AetheRZX/MECH_458/Enclsoure_CAD/trendnet-ti-pg160-1.snapshot.4/TRENDnet TI-PG160 Front Decal.png

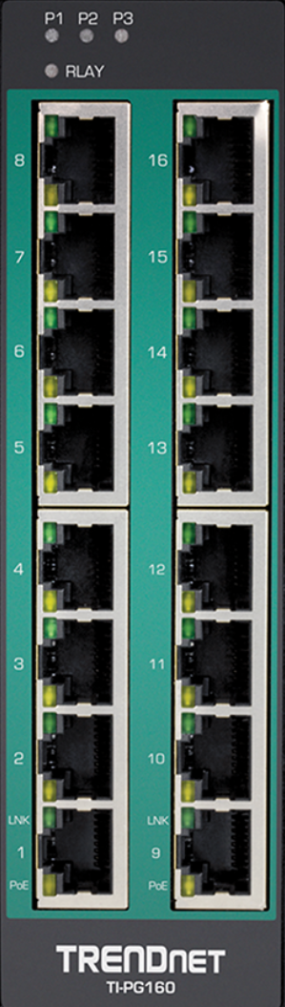
Enclsoure_CAD/trendnet-ti-pg160-1.snapshot.4/TRENDnet TI-PG160 Front Decal.png
