AetheRZX/MECH_458/Poster/Airbus_Flip_Table_Poster_36x48.html

AIRBUS

Robotics — Flip Table Redesign

AIRBUSFLIP TABLE

Automated Vertical & Rotational Positioning System

TEAM T2

THE UNIVERSITY OF BRITISH COLUMBIA

Faculty of Applied Science · Mechanical Engineering

Kenneth · Gyan · Ryan · Oliver · Mfon · Jordan

Project Overview

Client: Airbus Robotics

Flip tables are large tabletops (~2.4 m × 1.8 m) that vertically translate and rotate. They simulate fuselage positions for robots used to drill or install fasteners on an aircraft fuselage at different orientations.

Problem

Current flip tables are manually rotated and difficult to operate, limiting throughput and introducing ergonomic risk for operators.

Objectives & Scope

- Redesign the flip table to implement automated vertical and rotational motion
- Integrate a safety system and Human-Machine Interface (HMI)
- Improve ergonomic design and ease of access over and under the table
- Achieve a minimum vertical speed of 0.05 m/s

*Rotation was downscoped after client discussion — a separate detailed rotation design will be provided.

Design Process

1

Client Needs & Requirements

→

2

Concept Generation

→

3

Detailed Design & FEA

→

4

Prototype Build & Test

Prototype Specifications

Parameter | Value
Table Dimensions | ~2.4 m × 1.8 m
Under-Table Clearance | ≥ 6 ft (min.)
Static Load Capacity | 1,000 lb
Dynamic Load Capacity | 500 lb
Vertical Speed | ≥ 0.05 m/s
Safety System | E-Stop, Light Curtain
HMI | Touchscreen + Physical Controls

Evaluation Criteria

Ergonomics

30%

Time to Design

20%

Time to Build

15%

Cost

15%

Min. Height

10%

Angular Stability

10%

Final CAD Assembly

↑ Insert final CAD render / photograph here

Key Performance Metrics

6 ft+

Under-table Clearance

1000 lb

Static Load Capacity

500 lb

Dynamic Load Capacity

0.05 m/s

Min. Vertical Speed

HMI Control Interface

AIRBUS FLIP TABLE

SYSTEM READY

HEIGHT

3.50

ft

TARGET

7.00

ft

ANGLE

30.0

deg

▲ UP

⌂ HOME

■ E-STOP

FEA Stress Analysis

↑ Insert FEA stress analysis screenshot here

Testing & Validation

Verification Criteria

Test | Target | Result
Vertical Translation | ≥ 0.05 m/s | ✓ PASS
Static Load | 1,000 lb | ✓ PASS
Dynamic Load | 500 lb | ✓ PASS
Under-Table Clearance | ≥ 6 ft | ✓ PASS
E-Stop Response | < 1 s | ✓ PASS
Angular Stability | ≤ 0.5° | ~ CHECK

Prototype Photo

↑ Insert prototype photograph here

Subsystem Breakdown

Vertical

Complete

Rotational

Design Only

Electrical

Complete

Controls / HMI

Complete

Safety

Integrated

Recommendations

Overall

Add safety cage / light curtain Reduce assembly weight Redesign for DFMA

Vertical Subsystem

Use stainless steel channels Add polycarbonate cover Add rigging provisions

Rotational Subsystem

Lower torque brake & gearbox combo Improve redundant braking

Electrical & Controls

Safety switch on cabinet Refine control algorithm

AIRBUS ROBOTICS · Capstone Project 2025–2026

UBC Mechanical Engineering · Design & Innovation Day

TEAM T2 · 36″ × 48″ Poster
