AetheRZX/MECH_458/Poster/Airbus_Flip_Table_Poster_36x48.pptx

AIRBUS FLIP TABLE

Automated Vertical & Rotational Positioning System

PROJECT OVERVIEW

CLIENT: AIRBUS ROBOTICS

Flip tables are large tabletops (~2.4m × 1.8m) that vertically translate and rotate. They simulate fuselage positions for robots used to drill or install fasteners on an aircraft fuselage at different orientations.

PROBLEM

Current flip tables are manually rotated and difficult to operate, limiting throughput and introducing ergonomic risk for operators.

OBJECTIVE

Redesign the flip table to implement automated vertical translation with integrated safety, HMI, and improved ergonomics.

AIRBUS

ROBOTICS · CAPSTONE 2025–2026

FINAL CAD ASSEMBLY

INSERT CAD RENDER / 3D MODEL HERE

THE UNIVERSITY OF BRITISH COLUMBIA

Mechanical Engineering · Team T2

Kenneth · Gyan · Ryan · Oliver · Mfon · Jordan

KEY PERFORMANCE METRICS

6 ft+

Under-Table
Clearance

1000 lb

Static Load
Capacity

500 lb

Dynamic Load
Capacity

0.05 m/s

Min. Vertical
Speed

TEAM T2

SCOPE & REQUIREMENTS

- Automate vertical and rotational motion
- Integrate safety system & Human-Machine Interface (HMI)
- Improve ergonomic design and operator access
- Minimum vertical speed: 0.05 m/s
- Min. 6 ft clearance under tabletop
- Static load: 1,000 lb | Dynamic load: 500 lb

*Rotation downscoped after client discussion — separate detailed design provided.

TESTING & VALIDATION

TEST | TARGET | RESULT
Vertical Translation | ≥ 0.05 m/s | ✓ PASS
Static Load | 1,000 lb | ✓ PASS
Dynamic Load | 500 lb | ✓ PASS
Under-Table Clearance | ≥ 6 ft | ✓ PASS
E-Stop Response | < 1 s | ✓ PASS
HMI Response | < 0.5 s | ✓ PASS
Angular Stability | ≤ 0.5° | ~ CHECK

FEA STRESS ANALYSIS

INSERT FEA RESULTS IMAGE HERE

Low

WIRING DIAGRAM

Replace with actual wiring schematic

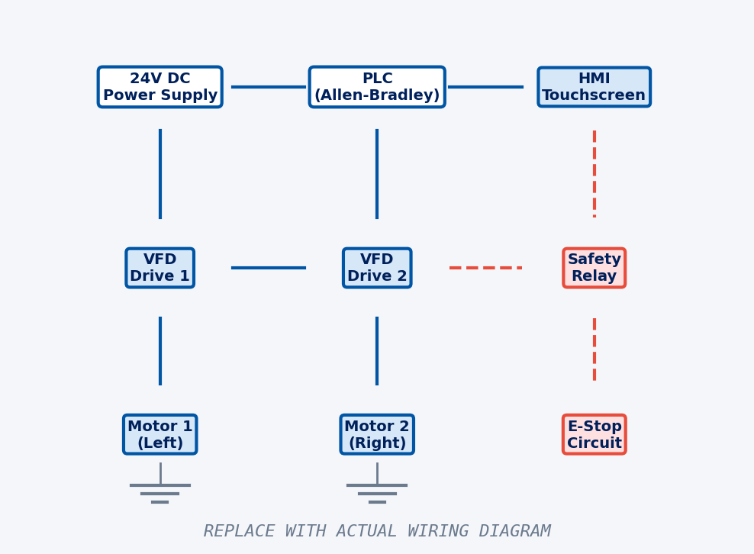
[picture p2: figure]

PROTOTYPE SPECIFICATIONS

PARAMETER | VALUE
Table Dimensions | ~2.4 m × 1.8 m
Under-Table Clearance | ≥ 6 ft (min.)
Static Load Capacity | 1,000 lb
Dynamic Load Capacity | 500 lb
Vertical Speed | ≥ 0.05 m/s
Safety System | E-Stop, Light Curtain
HMI | Touchscreen + Physical Controls
Rotation | Design provided separately

LOAD vs. DISPLACEMENT

Placeholder data — replace with actual test results

High

PROTOTYPE

INSERT PROTOTYPE PHOTO HERE

EVALUATION CRITERIA

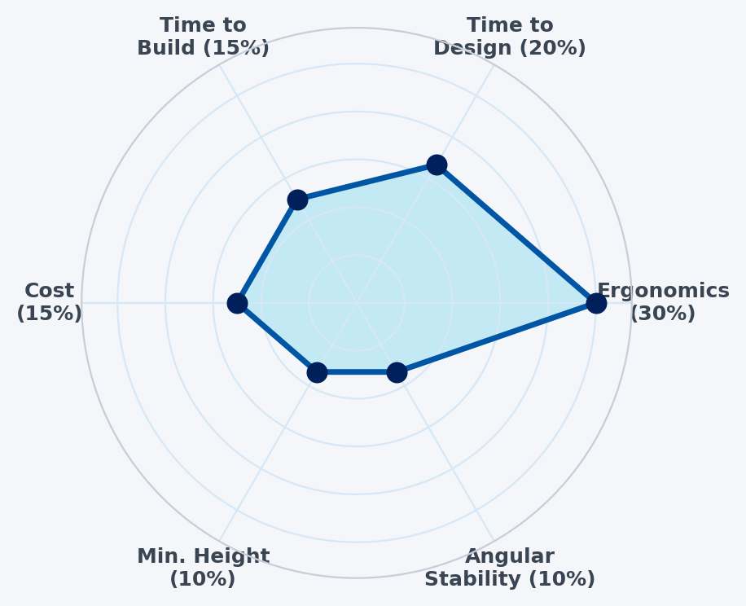
[picture p3: figure]

CONTROL SYSTEM ARCHITECTURE

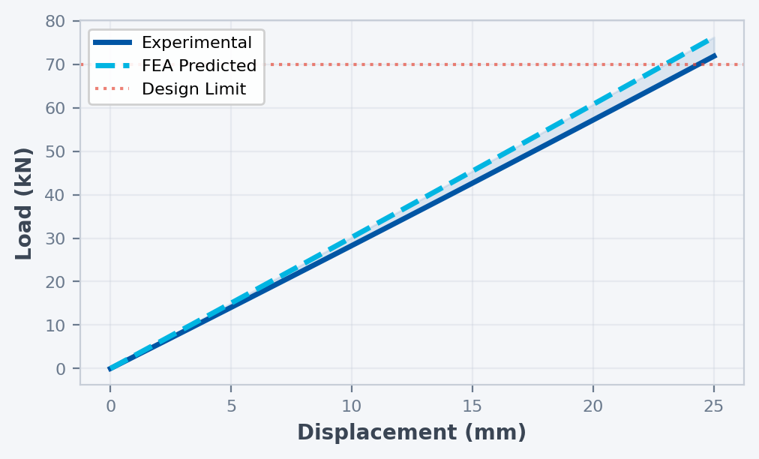
[picture p4: figure]

RECOMMENDATIONS

Overall

- Add safety cage or light curtain
- Reduce assembly weight
- Redesign for DFMA

Vertical Subsystem

- Optimize with stainless steel channels
- Add polycarbonate cover
- Add rigging provisions

Rotational Subsystem

- Lower torque brake & gearbox
- Improve redundant braking mechanism

Electrical & Controls

- Add safety switch on cabinet
- Refine PID control algorithm

DESIGN PROCESS

Client Needs &
Requirements

1

→

Concept
Generation

2

→

Detailed
Design & FEA

3

→

Prototype
Build & Test

4

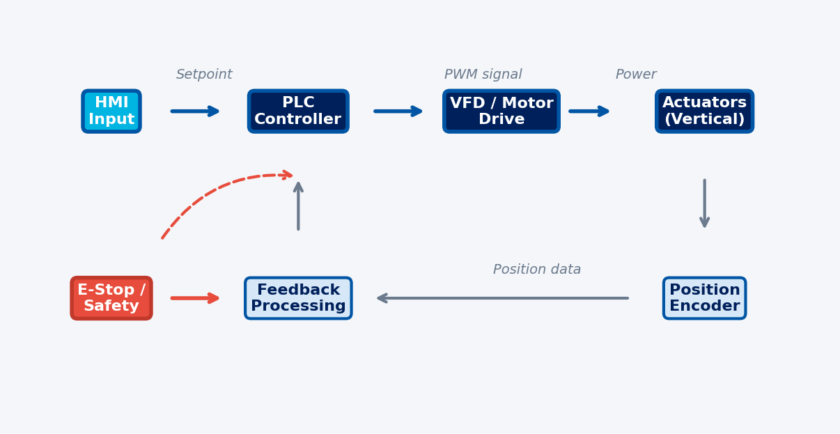
[picture p5: figure]

SYSTEM ARCHITECTURE

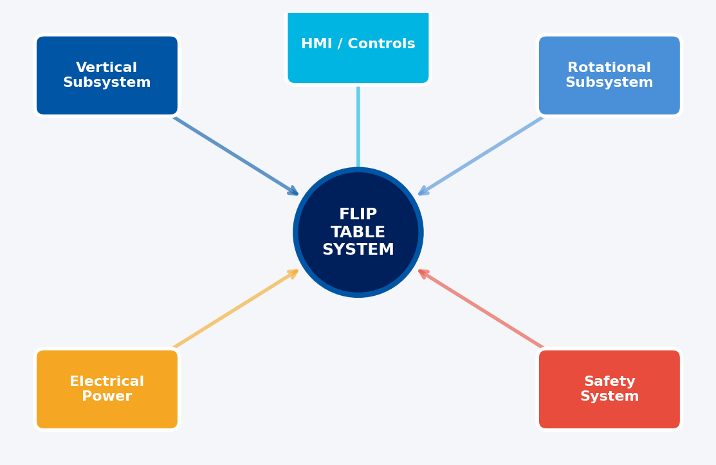
[picture p6: figure]

AIRBUS ROBOTICS · Capstone Project 2025–2026

UBC Mechanical Engineering · Design & Innovation Day

TEAM T2 · 36" × 48" Poster
