AetheRZX/MECH_458/Planning Document 2/combined_cropped.pdf

# Robotic Flip Table

## Airbus Robotics

8 | 9 | 10 11 12 13 14 | 15 16 17 18 19 20 21 | 22 23 24 25 26 27 28 | 29 30 | 1 | 2 | 3 | 4 | 5 | 6 | 7 | 8 | 9 | 10 11 12 | 13 14 15 16 17 18 19 | 20 21 22 23 24 25 26 | 27 28 29 30 31 | 1 | 2 | 3 | 4 | 5 | 6 | 7 | 8 | 9 | 10 11 12 13 14 15 # | # # # # # # # | # 25 26 27 28 29 30 | 1 | 2 | 3 | 4 | 5 | 6 | 7 | 8 | 9 10 11 12 13 # | # # # # # # # | # 23 24 25 26 27 28 | 29 30 31 1 | 2 | 3 | 4 | 5 | 6 | 7 | 8 | 9 10 11 12 13 # # # # # # # # # 23 24 25 26 27 28 29 30 31 1
M | T | W | T | F | S | S | M | T | W | T | F | S | S | M | T | W | T | F | S | S | M | T | W | T | F | S | S | M | T | W | T | F | S | S | M | T | W | T | F | S | S | M | T | W | T | F | S | S | M | T | W | T | F | S | S | M | T W T | F | S | S M T W T | F | S S M T W T F S S M | T W T | F | S | S M T W T | F | S | S M T W T | F | S S M T W T F S S M | T W T | F | S | S M T W T | F | S | S M T W T | F | S | S M T W T F S S M T W T F | S | S M T W T | F | S | S

### Dossier 1

1A - Project Overview | All | 100% | 9/9/25 | 9/12/25
1B - Initial Client Meeting | All | 100% | 9/12/25 | 9/14/25
1C - Stakeholder Identiifcation and User Assessment Mfon | 100% | 9/14/25 | 9/18/25
1D - Initial Survery of Existing Alernatives | Kenneth | 100% | 9/18/25 | 9/23/25
1E - Market Assessment | Oliver | 100% | 9/18/25 | 9/23/25
1F - User Interactions | Jordan | 100% | 9/18/25 | 9/23/25
Fix IP and NDA | Kenneth | 100% | 9/12/25 | 9/15/25
Schedule Client Weekly Meeting | Jordan | 100% | 9/15/25 | 9/16/25
Email PLC Access | Gyan, Ryan | 100% | 9/11/25 | 9/16/25
Set Up RT# and logistics | Kenneth | 100% | 9/19/25 | 9/22/25
Dossier 1 Review & Submission | 100% | 9/19/25 | 9/19/25

### Dossier 2 - Specifications

2A - Requirements | Gyan | 100% | 9/16/25 | 9/23/25
2B - Evaluation Criteria | Gyan | 100% | 9/18/25 | 9/23/25
2C - Value Equation | Oliver, Jordan, Gyan | 100% | 9/22/25 | 9/25/25

### Dossier 3 - Project Management

3A - Team Management Roles and Expectations | All | 100% | 9/16/25 | 9/22/25
3B - Team Contract | All | 100% | 9/16/25 | 9/22/25
3C - Scope of Work | Ryan, Oliver | 100% | 9/16/25 | 9/23/25
3D - Task Planning (PERT, CPM and Gantt Charts) | Ryan | 100% | 9/16/25 | 9/23/25
3E - Resources Required and Initial Budget Estimate Mfon | 100% | 10/2/25 | 10/6/25
3F - Team Meeting Minutes | All

### Dossier 4

4A/B - Formal Proposal for Client & Writing Quality Kenneth, Mfon | 100% | 9/20/25 | 9/30/25
4C - Presentation/Meeting | 100% | 9/20/25 | 9/24/25
4D - Agreement to Proceed | 100% | 9/25/25 | 9/30/25
Proposal Draft 1 Submission | Kenneth, Mfon | 100% | 10/1/25 | 10/1/25
Proposal Draft 2 Submission | 100% | 10/14/25 | 10/14/25
Dossier 4 Review & Submission | 100% | 10/14/25 | 10/14/25

### Dossier 5 - Needs Assessment

5A - Benchmarking of Existing Products/Processes Kenneth | 100% | 9/18/25 | 9/19/25
5B - Patent Review | All | 100% | 9/20/25 | 9/22/25
5C - Technical Literature Review | Jordan | 100% | 9/20/25 | 9/23/25
5D - Review of Relevant Regulatory Requirements and Established Best Practice All | 100% | 9/20/25 | 9/23/25
5E - Related Technologies | All | 100% | 9/22/25 | 9/23/25
5F - Updated Specifications | All | 100% | 9/22/25 | 9/27/25

### Dossier 6 - Concept Alternatives

6A - Functional Framework / Function Structure DiagramJordan | 100% | 9/27/25 | 10/11/25
6B - Concept Generation | All | 100% | 9/29/25 | 10/20/25
UBC Capstone Design Presentation & Review | All | 100% | 10/16/25 | 10/16/25
6C - Initial Concept Evaluation | All | 100% | 10/20/25 | 10/25/25
6D - Concept Screening and Concept Scoring | All | 100% | 10/20/25 | 10/28/25
6E - User Evaluation | All | 100% | 10/28/25 | 11/1/25
6F - Design Conflict Identification | All | 100% | 10/28/25 | 11/4/25
UBC Capstone Design Presentation & Review | All | 100% | 10/28/25 | 10/28/25
Design Selection for Prototyping | All | 100% | 11/7/25 | 11/7/25

### Dossier 7 - Critical Function Prototype

7A - Rationale and Plan | All | 100% | 11/7/25 | 11/14/25
7B - Documentation of the Prototype | All | 100% | 11/7/25 | 12/5/25
CFP Building | All | 100% | 11/7/25 | 12/5/25
CFP Collaborative Design Reviews | All | 100% | 11/13/25 | 11/13/25
7C - Testing, Analysis and Conclusions | All | 100% | 11/26/25 | 12/5/25
CFP Presentation & Review | All | 100% | 12/2/25 | 12/2/25
Working CFP Prototypes | All | 100% | 12/5/25 | 12/5/25

END

Sep 8, 2025 | Sep 15, 2025 | Sep 22, 2025 | Sep 29, 2025
TASK | ASSIGNED TO | PROGRESS | START
Nov 3, 2025 | Nov 10, 2025 | Nov 17, 2025 | Nov 24, 2025
Project start: | Tue, 9/9/2025 | Project End: | Thu, 4/16/2026
Display week: | 1
Oct 6, 2025 | Oct 13, 2025 | Oct 20, 2025 | Oct 27, 2025 | Dec 1, 2025 | Dec 8, 2025 | Dec 15, 2025 | Dec 22, 2025 | Dec 29, 2025 | Jan 5, 2026 | Jan 12, 2026 | Jan 19, 2026 | Jan 26, 2026

29 30 31 | 1 | 2 | 3 | 4 | 5 | 6 | 7 | 8 | 9 | 10 11 | 12 13 14 15 | 16 | 17 18 | 19 20 21 22 23 24 25 | 26 27 28 29 30 31 | 1 | 2 | 3 | 4 | 5 | 6 | 7 | 8 | 9 | 10 11 12 13 14 15 | 16 17 18 19 20 21 22 | 23 24 25 26 27 28 1 | 2 | 3 | 4 | 5 | 6 | 7 | 8 | 9 # 11 # # # # | # 17 18 19 20 21 22 | 23 24 25 26 27 28 29 | 30 31 1 | 2 | 3 | 4 | 5 | 6 7 8 9 # # # | # 14 15 16 17 18 19 | 20
M | T | W | T | F | S | S | M | T | W | T | F | S | S | M | T | W | T | F | S | S | M | T | W | T | F | S | S | M | T | W | T | F | S | S | M | T | W | T | F | S | S | M | T | W | T | F | S | S | M | T | W | T | F | S | S | M | T | W | T | F | S | S | M | T | W | T | F | S | S | M | T | W | T | F | S | S | M | T | W | T | F | S | S | M | T | W | T | F | S | S | M | T | W | T | F | S | S | M | T | W | T | F | S | S | M | T | W | T | F | S | S | M

### END

Dec 29, 2025 | Jan 5, 2026 | Jan 12, 2026 | Jan 19, 2026
TASK | ASSIGNED TO | PROGRESS | START
Jan 26, 2026 | Feb 2, 2026 | Feb 9, 2026 | Feb 16, 2026 | Feb 23, 2026 | Mar 2, 2026 | Mar 9, 2026 | Mar 16, 2026 | Mar 23, 2026 | Mar 30, 2026 | Apr 6, 2026 | Apr 13, 2026

## Dossier 8 - Technical Analysis

8A - Concept Selection Memo for Client | Oliver, Gyan | 20% | 1/8/26 | 1/28/26
8B - Technical Analysis Plan | Ryan, Kenneth | 80% | 1/8/26 | 1/28/26
8C - System Architecture Diagram | Ryan, Gyan | 80% | 1/8/26 | 1/28/26
8D - Modelling | Ryan, Mfon | 50% | 1/8/26 | 1/28/26
8E - Optimization | Ryan, Oliver | 40% | 1/8/26 | 1/28/26
Technical Analysis CDR | All | 40% | 1/15/26 | 1/15/26
Prototype Analysis Report | All | | 1/30/26 | 1/30/26

## Dossier 9 - Design Review

9A - Risk Assessment | Jordan | 50% | 1/8/26 | 1/14/26
9B - Safety Planning | Kenneth | 70% | 1/16/26 | 1/21/26
9C - Updated Budget | Oliver | 60% | 1/8/26 | 1/23/26

## Dossier 10 - Detailed Prototype Design

10A - Prototype Design Log | All | 20% | 1/23/26 | 3/13/26
Bill of Materials | All | 50% | 1/8/26 | 1/30/26
Procurement & Lead-Time Tracking | Oliver | 40% | 1/10/26 | 2/10/26
Updated Requirement & Testing Matrix | Kenneth | 30% | 1/8/26 | 1/16/26
10B - Detailed Calculations | All | 70% | 1/12/26 | 1/23/26
10C - CAD File of Final Prototype | Jordan, Mfon | 50% | 1/17/26 | 1/30/26
10D - Controls Implementation | | 20% | 2/10/26 | 3/25/26
10E - Prototype Building | | | 2/10/26 | 3/11/26
10E_i - Mechanical Assembly | | | 2/10/26 | 3/11/26
10E_ii - Electrical Wiring | | | 2/17/26 | 3/11/26
10E_iii - HMI and UI implementation | | | 2/20/26 | 3/11/26
Working Prototype | | | 3/11/26 | 3/13/26
Prototype Assessment Memo | | | 3/14/26 | 3/17/26

## Dossier 11 - Verification and Validation

Iteration | | | 3/13/26 | 4/2/26
11A - Verification (Evaluation of Specifications) | | | 3/14/26 | 3/23/26
Draft Verification Test Procedures | | | 3/24/26 | 3/29/26
Dry-Run Verification Tests & Procedure Refinement | 3/29/26 | 4/3/26
Data Processing & Analysis Scripts | | | 3/24/26 | 3/29/26
User Manual / Quick-Start & Maintenance Checklist | 3/24/26 | 3/29/26
11B - Validation (User Evaluation) | | | 3/23/26 | 4/2/26
Safety Validation and Verification Document | | | 4/3/26 | 4/3/26
Final Prototype Design Evaluations | | | 4/4/26 | 4/4/26

## Dossier 12 - Project Wrap-Up

12A - Design and Innovation Day | | | 4/9/26 | 4/9/26
12B - Final Report | | | 4/4/26 | 4/12/26
12C - Public Web Abstract | | | 4/4/26 | 4/12/26
12D - Electronic Archive | | | 4/4/26 | 4/12/26
12E - Logbook Submission | | | 4/4/26 | 4/12/26
12F - Personal Reflection | | | 4/4/26 | 4/12/26
12G - Client Review + Assessment Form | | | 4/13/26 | 4/13/26
12H - Client Check-Off Form | | | 4/13/26 | 4/13/26
12I - Financial Statement | | | 4/7/26 | 4/13/26
12J - Locker/Workspace Cleanout Form | | | 4/10/26 | 4/13/26
Final Documentation Completion | | | 4/12/26 | 4/12/26
Project Completion | | | 4/12/26 | 4/12/26

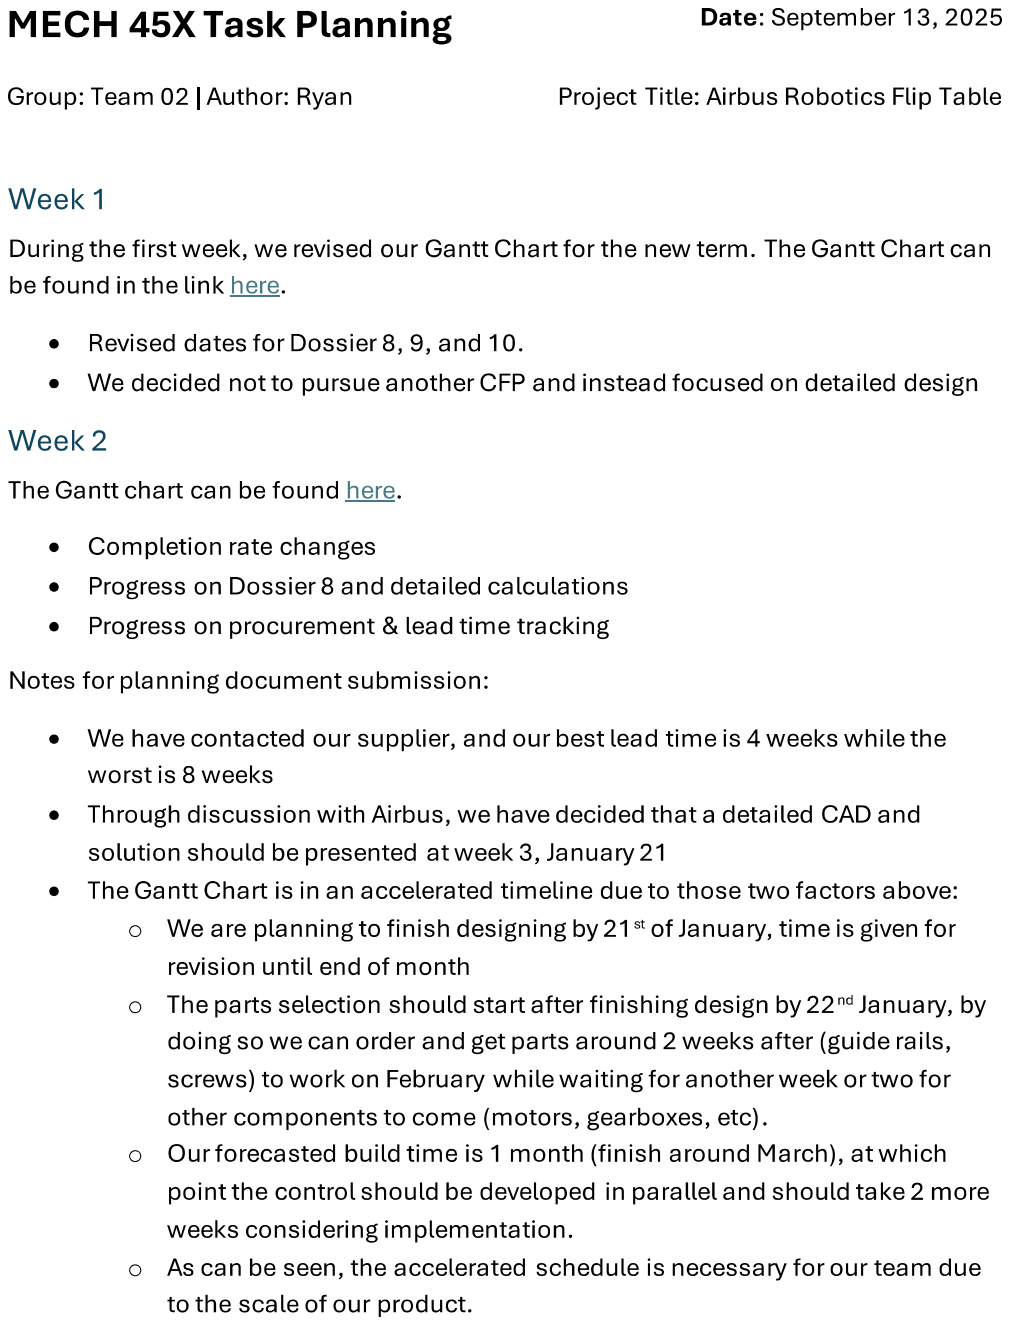
[picture p23: page 3]
