AetheRZX/MECH_458/Planning Document 2/Planning_document2.pdf

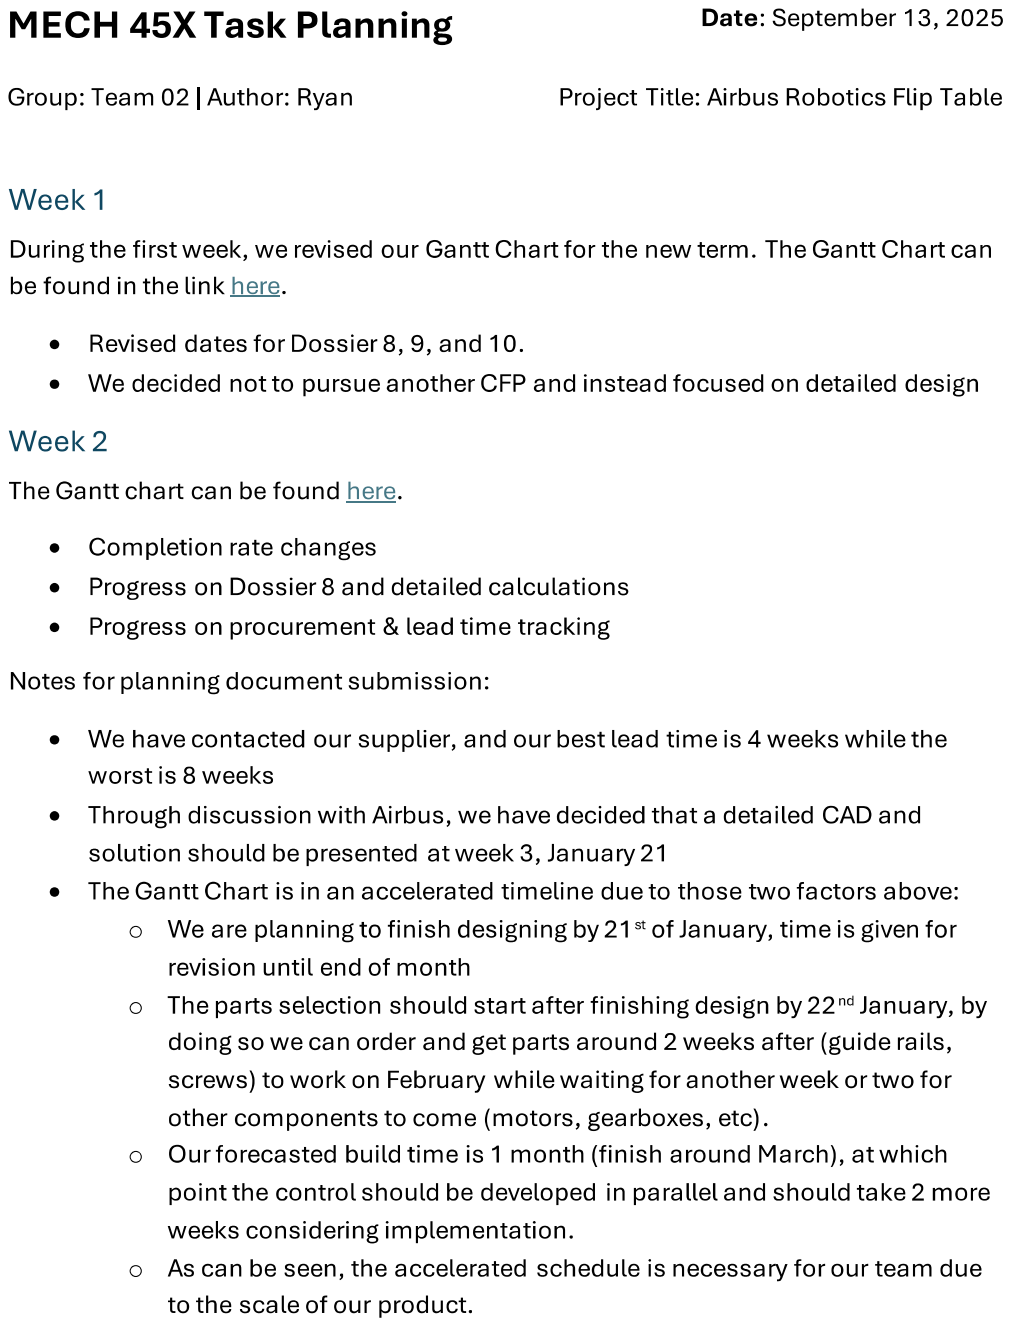
[picture p24: page 1]
