AetheRZX/MECH_458/CAD/2025 Solidworks/2025 SOLIDWORKS/Screenshot 2026-01-11 163408.png

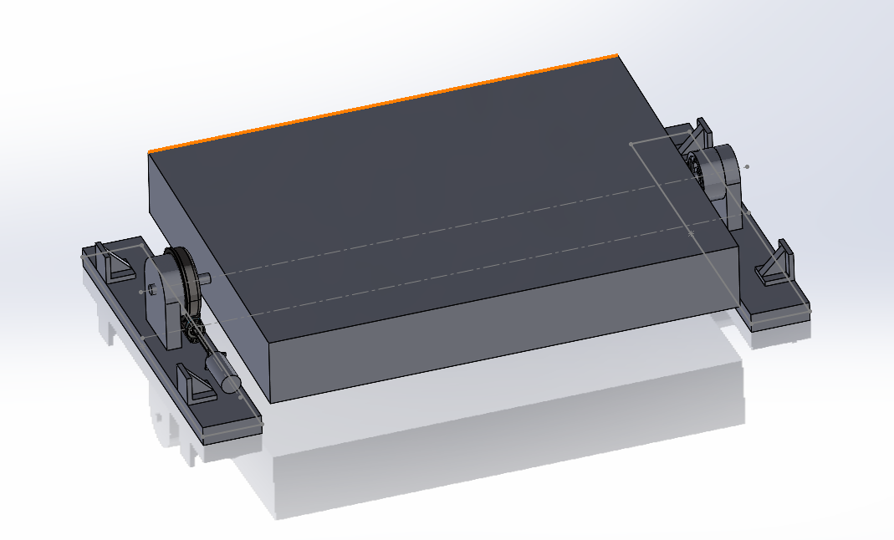
CAD/2025 Solidworks/2025 SOLIDWORKS/Screenshot 2026-01-11 163408.png
