AetheRZX/MECH_458/Dossier 8/diagram1.png

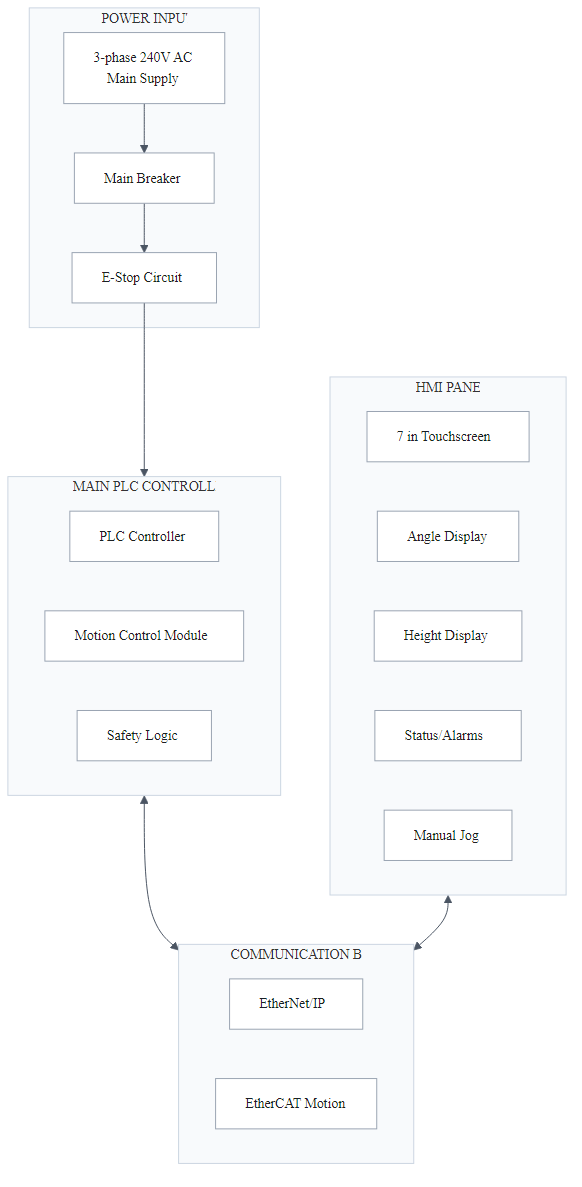
Dossier 8/diagram1.png
