AetheRZX/MECH_458/Dossier 8/diagram2.png

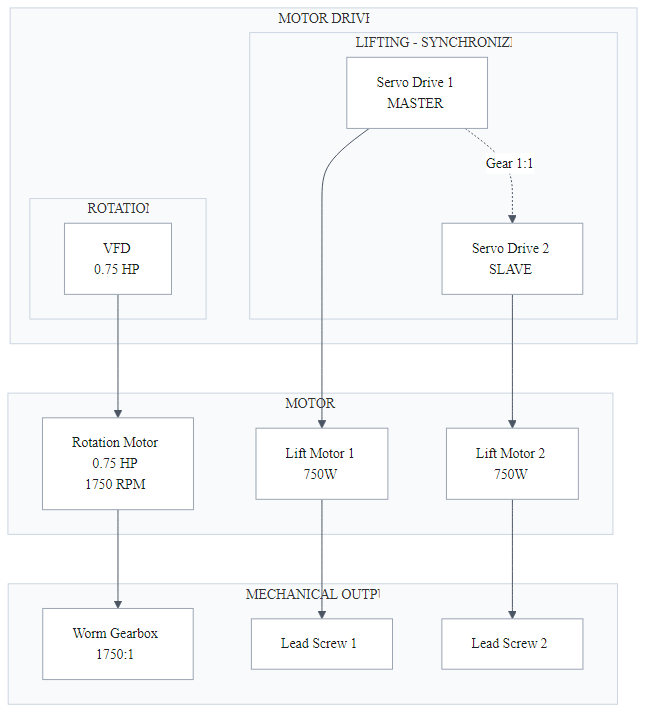
Dossier 8/diagram2.png
