AetheRZX/MECH_458/Dossier 8/diagram3.png

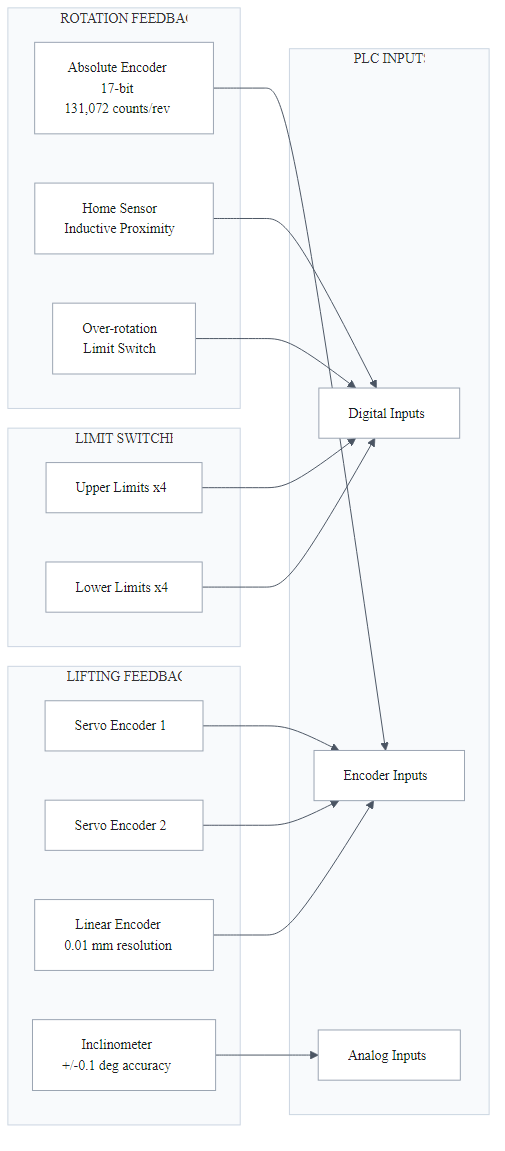
Dossier 8/diagram3.png
