AetheRZX/MECH_458/Dossier 8/diagram4.png

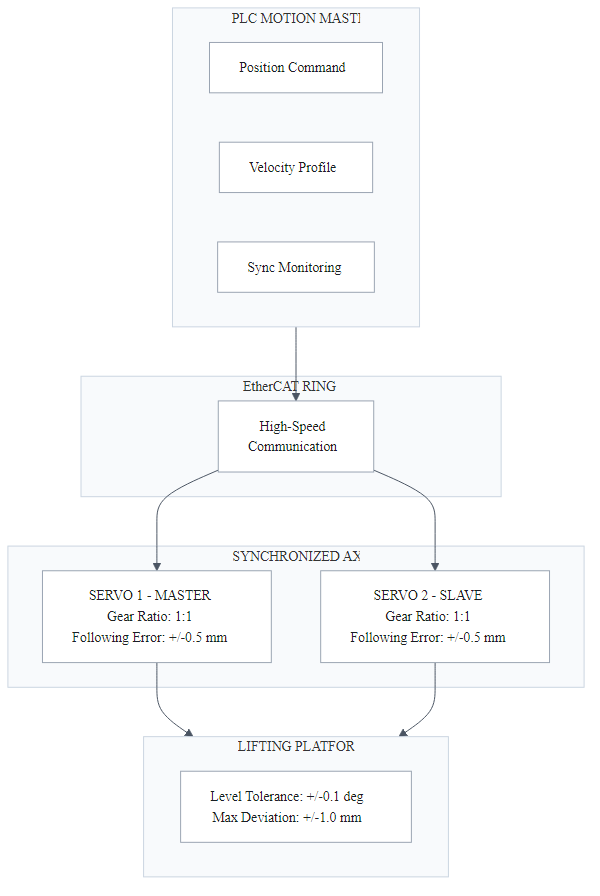
Dossier 8/diagram4.png
