AetheRZX/MECH_458/Dossier 8/diagram5.png

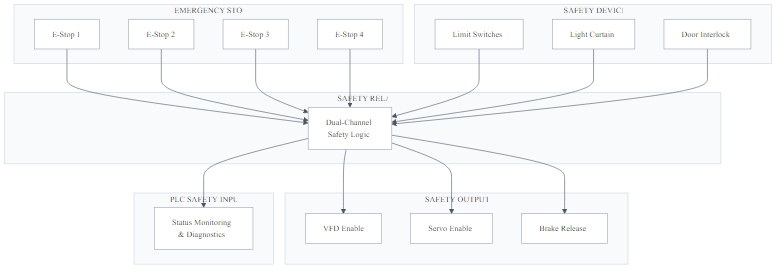
Dossier 8/diagram5.png
