AetheRZX/MECH_458/Dossier 8/diagram6.png

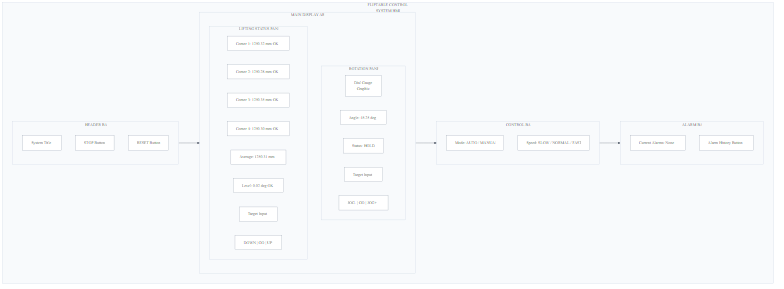
Dossier 8/diagram6.png
