AetheRZX/MECH_458/Enclsoure_CAD/trendnet-ti-pg160-1.snapshot.4/Screenshot 2024-08-30 090922.png

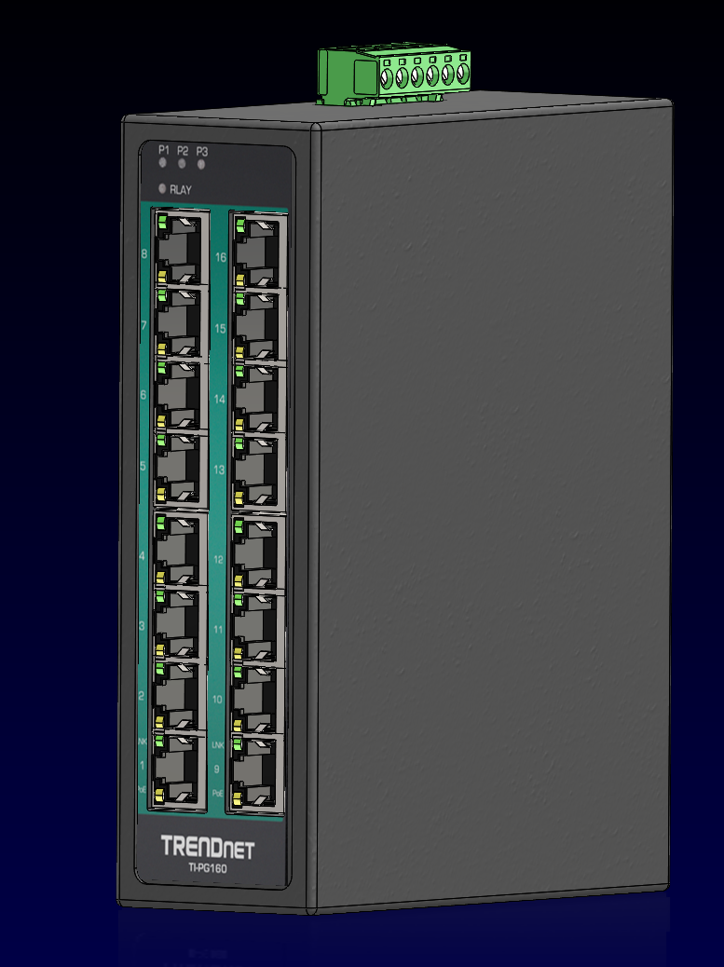
Enclsoure_CAD/trendnet-ti-pg160-1.snapshot.4/Screenshot 2024-08-30 090922.png
