AetheRZX/MECH_458/motor_lift_simulation_plot.png

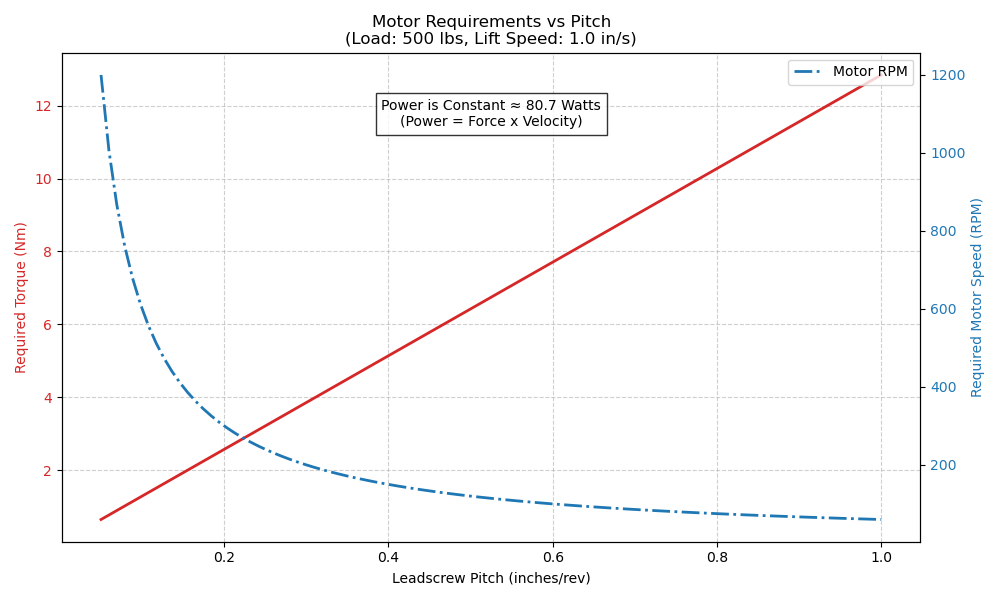
motor_lift_simulation_plot.png
