AetheRZX/MECH_458/shaft_analysis_complete.png

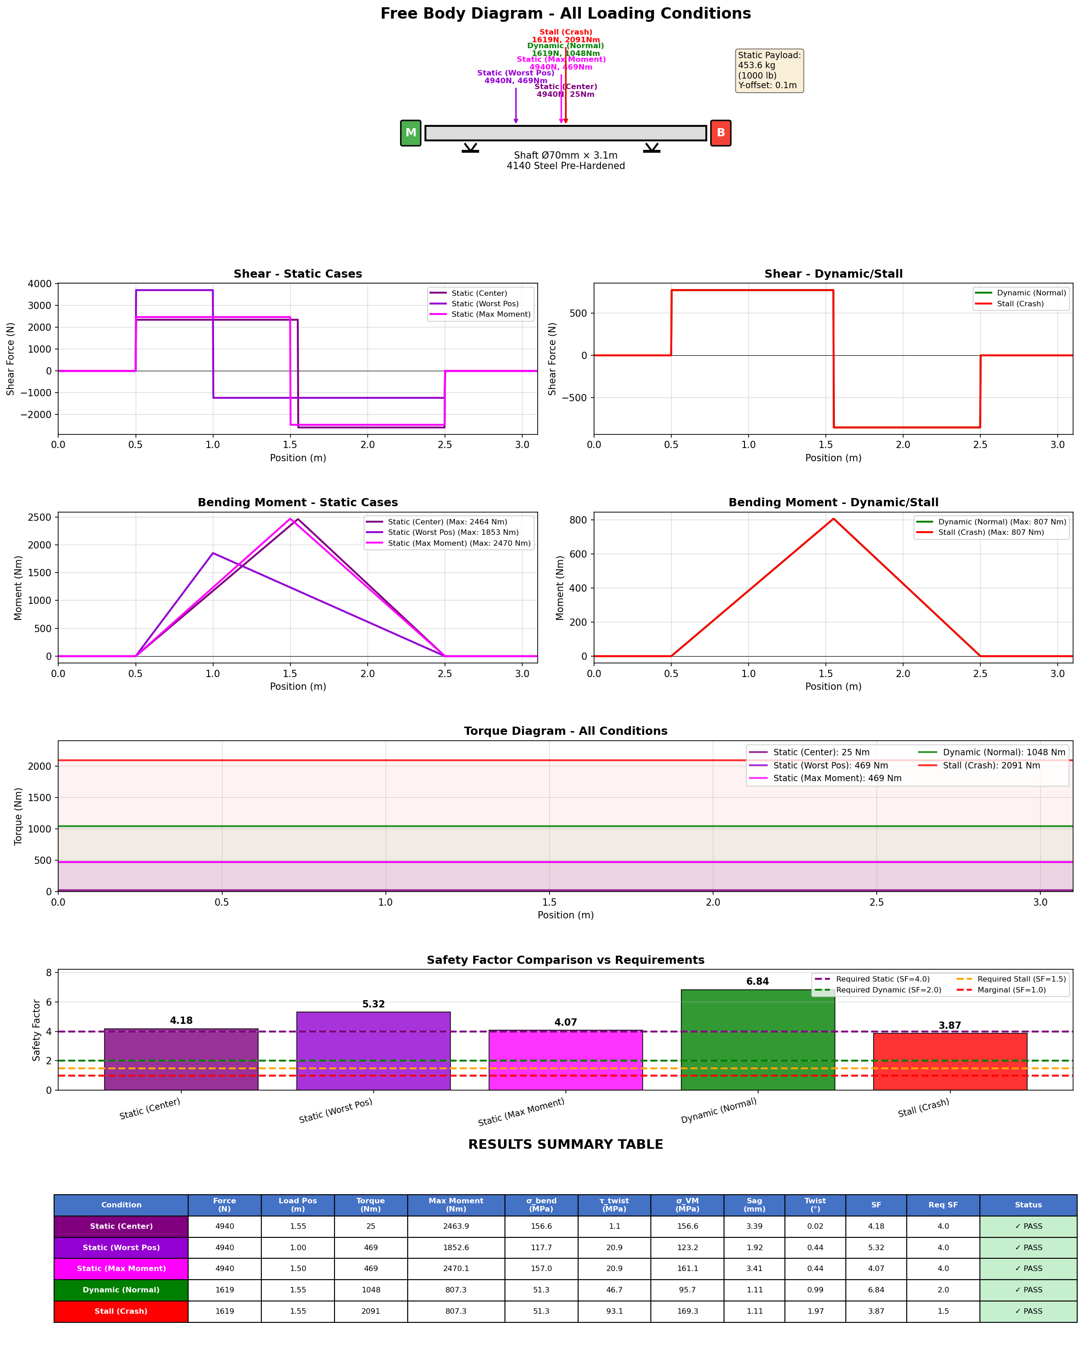
shaft_analysis_complete.png
