AetheRZX/MECH_458/shaft_analysis_dual_condition.png

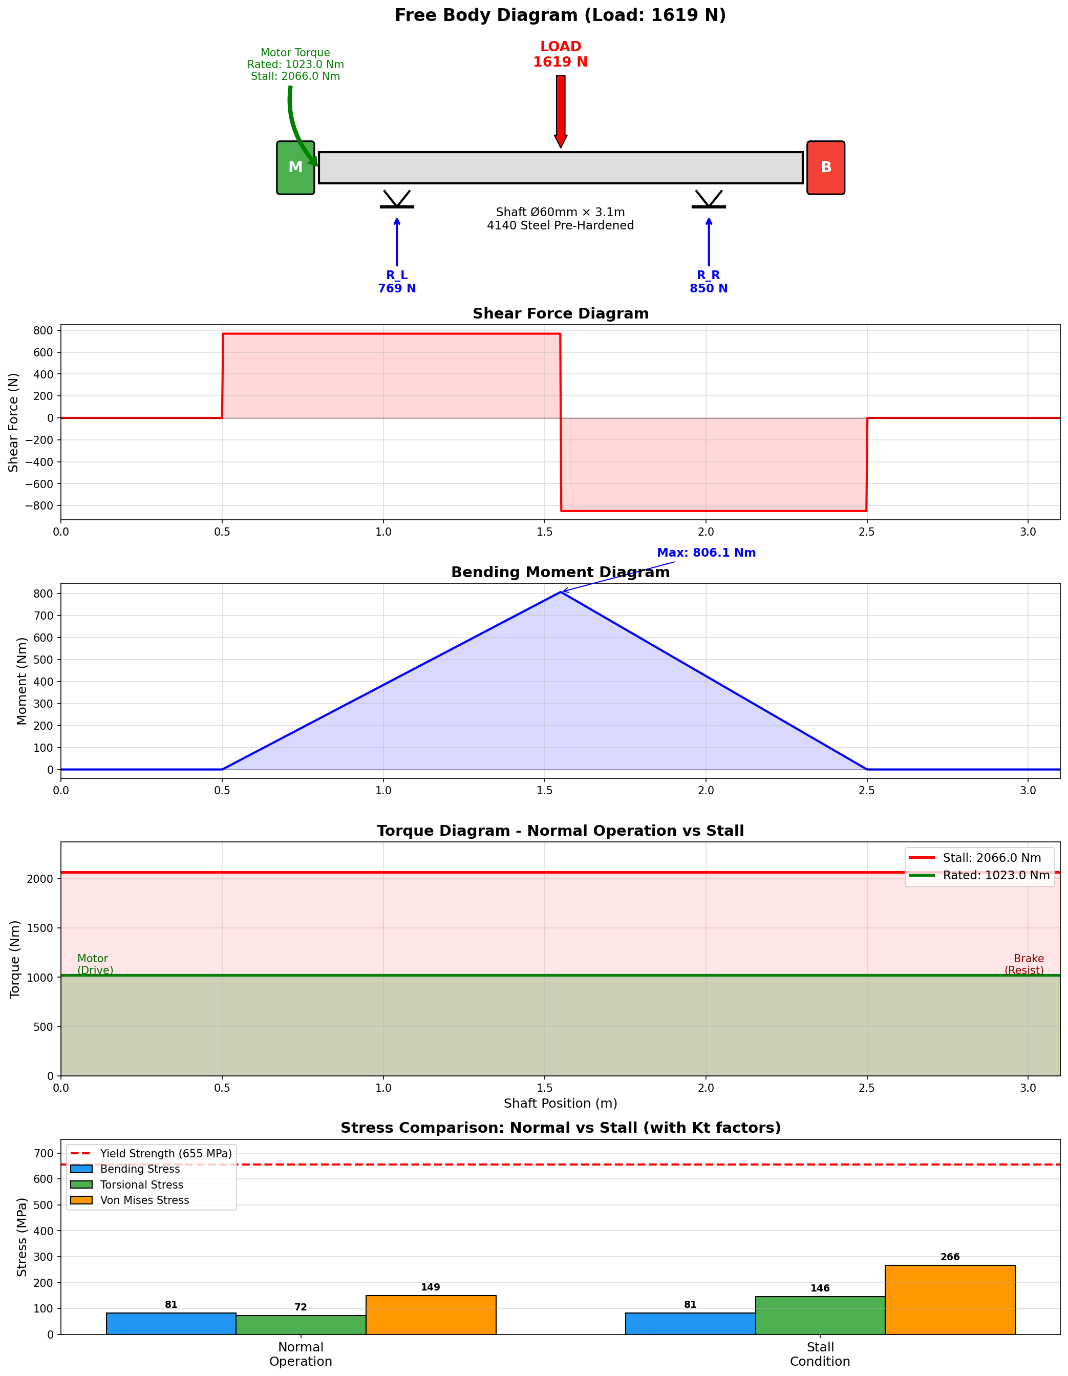
shaft_analysis_dual_condition.png
