AetheRZX/MECH_458/Poster/CAD_files and pics/Control_Panel_Wiring_Checklist.xlsx

Sheet: Summary & Coding
System Component | Hardware Model | Role / Coding Note
PLC (Master) | S7-1214FC DC/DC/Rly | Executes logic, synchronizes axes. Needs PROFINET config in TIA Portal.
VFD Control Unit 1 | SINAMICS CU250S-2 | Drives Motor 1. Add as Positioning Axis Technology Object.
VFD Control Unit 2 | SINAMICS CU250S-2 | Drives Motor 2. Add as second Axis. Synchronize with Axis 1.
Power Module (x2) | SINAMICS PM240-2 | Muscle for the drives. Configured via the attached CU.
HMI | Kinco GL100E 10.1" | Operator interface. Will read/write to PLC data blocks.
Ethernet Switch | TRENDnet 8-Port | Central network hub. Unmanaged.
E-Stop (Prototype) | Siemens 2NC | Wired to standard inputs. Write LAD logic to drop drive Enable.
Braking Resistors | Kinco / Siemens | PLC monitors thermal switches for fault logic.
Limit Switches | Omron WLCA2-N | Home and End positions. Assign to axis limits in TIA.

Sheet: Power Distribution
Component ID | From | To | Wire / Terminal | Status | Notes
Main AC | Wall Outlet | Circuit Breaker | Line & Neutral |  | LOCK OUT POWER
VFD AC 1 | Circuit Breaker | PM240-2 #1 (L1, L2/N) | Mains wiring |  | Provide star ground
VFD AC 2 | Circuit Breaker | PM240-2 #2 (L1, L2/N) | Mains wiring |  | Provide star ground
DC PSU | AC Mains | 24V DC PSU In | AC L, N, Ground |  | Mount on DIN
PLC Pwr | 24V PSU | S7-1214FC | Standard wire
HMI Pwr | 24V PSU | Kinco HMI | Standard wire
Switch Pwr | 24V PSU | TRENDnet Switch | Standard wire
CU Pwr 1 | 24V PSU | CU250S-2 #1 | Standard wire
CU Pwr 2 | 24V PSU | CU250S-2 #2 | Standard wire
Ground | Main Ground | Enclosure Chassis | Bare Copper |  | Scrape paint!

Sheet: VFD & Motor
Component ID | From | To | Connection Details | Status | Notes
Motor 1 | PM240-2 #1 (U,V,W) | Motor 1 | CF29.D Cable |  | Ground is solid
Motor 2 | PM240-2 #2 (U,V,W) | Motor 2 | CF29.D Cable |  | Ground is solid
Encoder 1 | Motor 1 Encoder | CU250S-2 #1 | CF11 Sub-D
Encoder 2 | Motor 2 Encoder | CU250S-2 #2 | CF11 Sub-D
Resistor 1 | Blue Wires 1 | PM240-2 #1 (DCP, R2) | High Voltage |  | NO DCN!
Resistor 2 | Blue Wires 2 | PM240-2 #2 (DCP, R2) | High Voltage |  | NO DCN!
Brake Relay 1 | Relay 1 | CU250S-2 #1 | Harness
Brake Relay 2 | Relay 2 | CU250S-2 #2 | Harness
Mech Brake 1 | Relay 1 Out | Motor 1 Brake Lines | In CF29.D
Mech Brake 2 | Relay 2 Out | Motor 2 Brake Lines | In CF29.D

Sheet: PLC IO Map
I/O Terminal | Signal Type | Component connected | Wiring Path | Status | TIA Tag Name
1M | Common GND | 24V PSU 0V | Black / Blue Wire
DI a.0 | Digital Input | E-Stop Ch 1 | 24V -> Block 1 -> DI a.0 |  | I_Estop_Ch1
DI a.1 | Digital Input | E-Stop Ch 2 | 24V -> Block 2 -> DI a.1 |  | I_Estop_Ch2
DI a.2 | Digital Input | Lim SW 1 (M1 Home) | 24V -> Switch NC -> DI a.2 |  | I_Limit_M1_Home
DI a.3 | Digital Input | Lim SW 2 (M1 End) | 24V -> Switch NC -> DI a.3 |  | I_Limit_M1_End
DI a.4 | Digital Input | Lim SW 3 (M2 Home) | 24V -> Switch NC -> DI a.4 |  | I_Limit_M2_Home
DI a.5 | Digital Input | Lim SW 4 (M2 End) | 24V -> Switch NC -> DI a.5 |  | I_Limit_M2_End
DI a.6 | Digital Input | Resistor 1 Temp | 24V -> Brown Wire -> DI a.6 |  | I_Resistor1_Overtemp
DI a.7 | Digital Input | Resistor 2 Temp | 24V -> Brown Wire -> DI a.7 |  | I_Resistor2_Overtemp

Sheet: Network & Comms
Cable # | From | To | Type | Status | Notes
NET-01 | S7-1214FC | Switch | Cat6a |  | PLC is Master
NET-02 | Kinco HMI | Switch | Cat6a |  | Same subnet
NET-03 | CU250S-2 #1 | Switch | Cat6a |  | Assign Device Name
NET-04 | CU250S-2 #2 | Switch | Cat6a |  | Assign Device Name
