AetheRZX/MECH_458/CAD/Wooden Assembly Actual.STEP

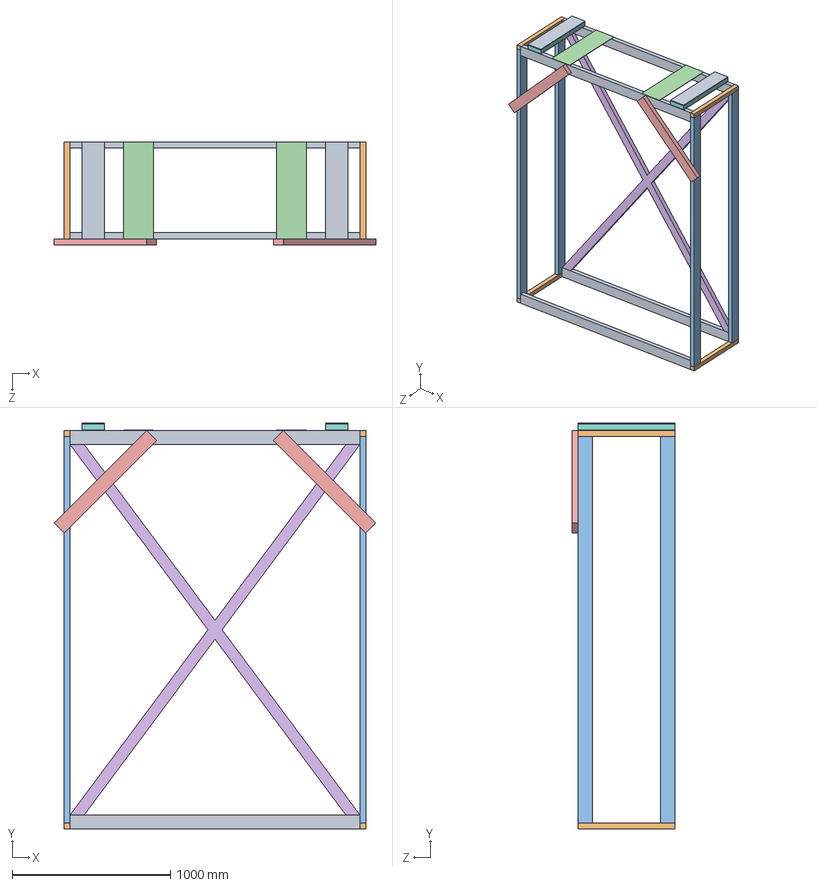
[picture p36: CAD file, 2026-04-04]
CAD/Wooden Assembly Actual.STEP
2030.7 x 2562.2 x 647.7 mm
Bottom Frame^Wooden Assembly Actual x 2
Bottom Frame Width^Wooden Assembly Actual x 2
Vertical Supports^Wooden Assembly Actual
Gear Box Mount^Wooden Assembly Actual
Gussets^Wooden Assembly Actual
Cross Bracing^Wooden Assembly Actual
Metal Blue Motor Mount^Blue Motor Mount Assem_Wooden Assembly Actual
Blue Motor Mount Sandwich^Blue Motor Mount Assem_Wooden Assembly Actual
Metal Sandwich Blue Motor Moutn^Blue Motor Mount Assem_Wooden Assembly Actual
