AetheRZX/MECH_458/Enclsoure_CAD/trendnet-ti-pg160-1.snapshot.4/TI-PG160 Build Assembly.STEP

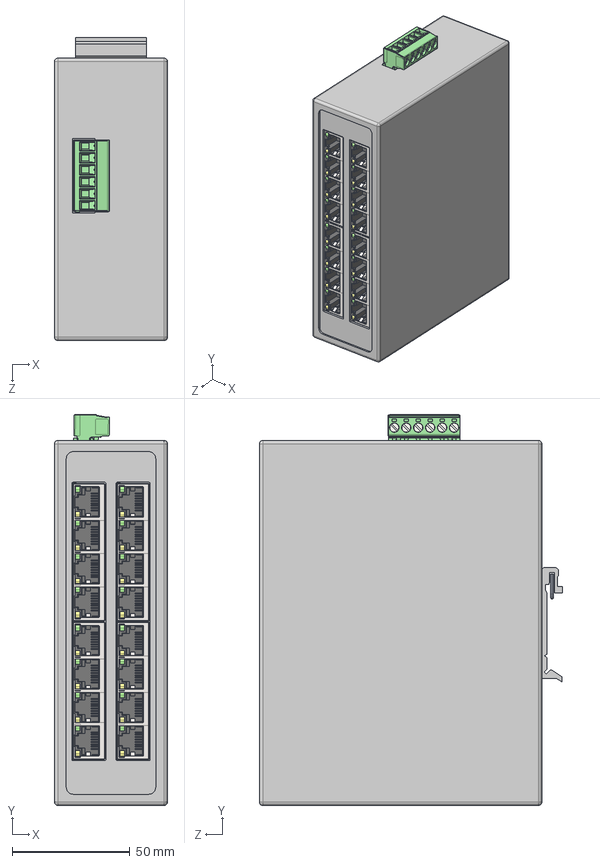
[picture p37: CAD file, 2026-04-04]
Enclsoure_CAD/trendnet-ti-pg160-1.snapshot.4/TI-PG160 Build Assembly.STEP
48.0 x 166.0 x 128.8 mm
TI-PG160 Enclosure
RJ45 Connector Array - 4 x 4
Connector Receptical
1757051 - Connector
DIN Rail Mount
