AetheRZX/MECH_458/CAD/Tabletop_Mock/mock_table_assembly.SLDASM

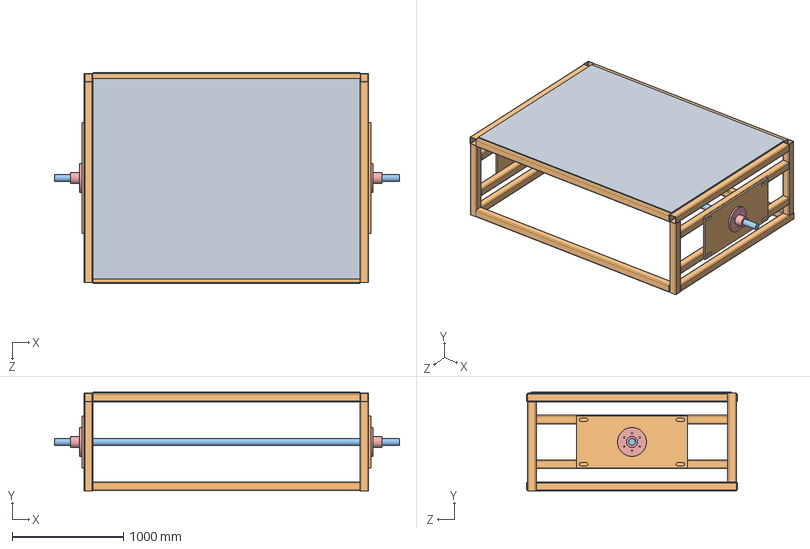
[picture p38: CAD file, 2026-03-04]
CAD/Tabletop_Mock/mock_table_assembly.SLDASM
3100.0 x 888.3 x 1894.1 mm
flange x 2
key_18x11x90
shaft
tabletop
aluminum_sheet
