AetheRZX/MECH_458/CAD/2023 SW/X Axis Assem1.SLDASM

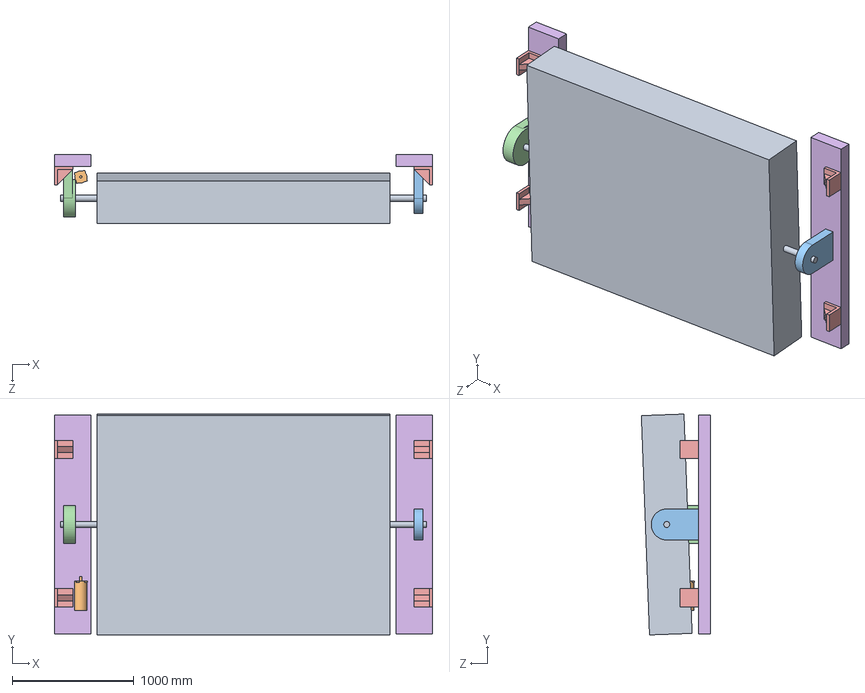
[picture p39: CAD file, 2026-01-17]
CAD/2023 SW/X Axis Assem1.SLDASM
3100.0 x 1811.7 x 568.5 mm
Platform x 2
L bracket custom x 4
Slew drive bracket
Brake bracket
motor brushless
tabletop simple
