AetheRZX/MECH_458/CAD/Tabletop_Mock/tabletop.SLDPRT

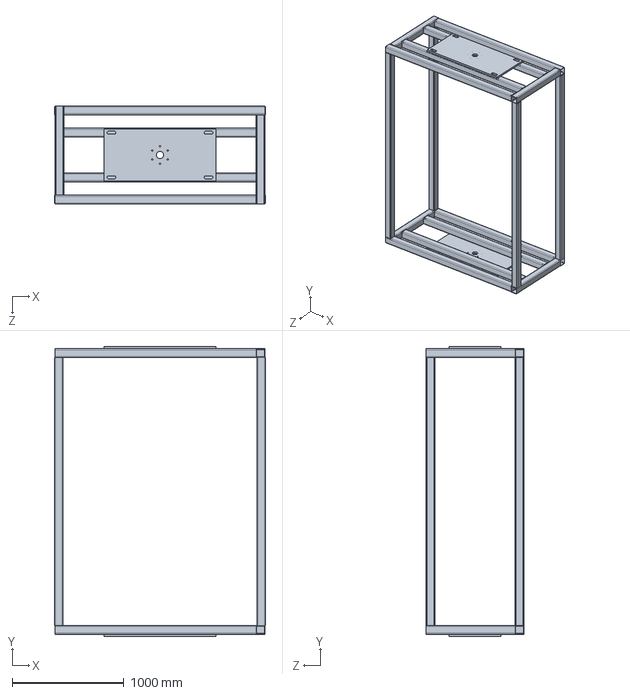
[picture p40: CAD file, 2026-03-04]
CAD/Tabletop_Mock/tabletop.SLDPRT
1894.1 x 2598.7 x 880.0 mm
