AetheRZX/MECH_458/Enclsoure_CAD/3dfindit-SIEMENS-6ES72281RC510AA0-22026032701535952449388d0b6156e/6ES72281RC510AA0.stp

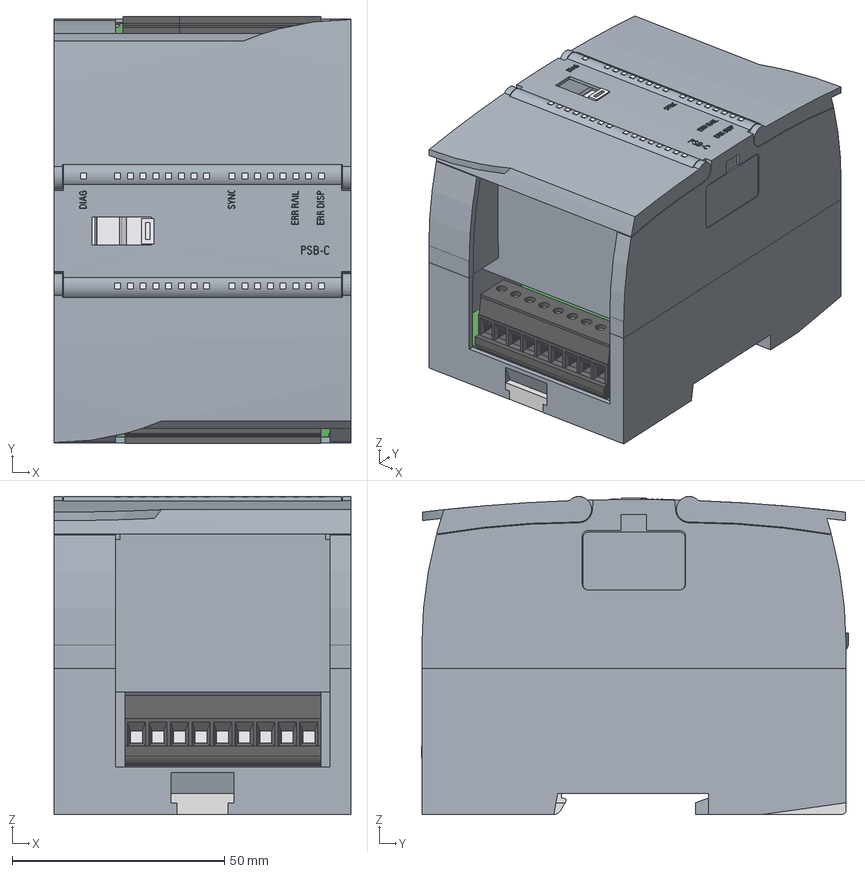
[picture p41: CAD file, 2026-04-04]
Enclsoure_CAD/3dfindit-SIEMENS-6ES72281RC510AA0-22026032701535952449388d0b6156e/6ES72281RC510AA0.stp
70.0 x 100.7 x 75.1 mm
6ES72281RC510AA0_PART1 x 2
6ES72281RC510AA0_PART2 x 2
6ES72281RC510AA0_PART3 x 2
6ES72281RC510AA0_PART4
6ES72281RC510AA0_PART5
6ES72281RC510AA0_PART6
6ES72281RC510AA0_PART7
6ES72281RC510AA0_PART8
6ES72281RC510AA0_PART9
6ES72281RC510AA0_PART10
6ES72281RC510AA0_PART11
6ES72281RC510AA0_PART12
6ES72281RC510AA0_PART13
6ES72281RC510AA0_PART14
6ES72281RC510AA0_PART15
6ES72281RC510AA0_PART16
6ES72281RC510AA0_PART17
6ES72281RC510AA0_PART18
6ES72281RC510AA0_PART19
6ES72281RC510AA0_PART20
6ES72281RC510AA0_PART21
6ES72281RC510AA0_PART22
6ES72281RC510AA0_PART23
6ES72281RC510AA0_PART24
6ES72281RC510AA0_PART25
6ES72281RC510AA0_PART26
6ES72281RC510AA0_PART27
6ES72281RC510AA0_PART28
6ES72281RC510AA0_PART29
6ES72281RC510AA0_PART30
6ES72281RC510AA0_PART31
6ES72281RC510AA0_PART32
6ES72281RC510AA0_PART33
6ES72281RC510AA0_PART34
6ES72281RC510AA0_PART35
6ES72281RC510AA0_PART36
6ES72281RC510AA0_PART37
6ES72281RC510AA0_PART38
6ES72281RC510AA0_PART39
6ES72281RC510AA0_PART40
6ES72281RC510AA0_PART41
6ES72281RC510AA0_PART42
6ES72281RC510AA0_PART43
6ES72281RC510AA0_PART44
6ES72281RC510AA0_PART45
6ES72281RC510AA0_PART46
6ES72281RC510AA0_PART47
6ES72281RC510AA0_PART48
6ES72281RC510AA0_PART49
6ES72281RC510AA0_PART50
6ES72281RC510AA0_PART51
6ES72281RC510AA0_PART52
6ES72281RC510AA0_PART53
6ES72281RC510AA0_PART54
6ES72281RC510AA0_PART55
6ES72281RC510AA0_PART56
6ES72281RC510AA0_PART57
6ES72281RC510AA0_PART58
6ES72281RC510AA0_PART59
6ES72281RC510AA0_PART60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
