AetheRZX/MECH_458/Enclsoure_CAD/3dfindit-SIEMENS-JJY_023151720007-22026032702052270251445d0b6156e/JJY_023151720007.stp

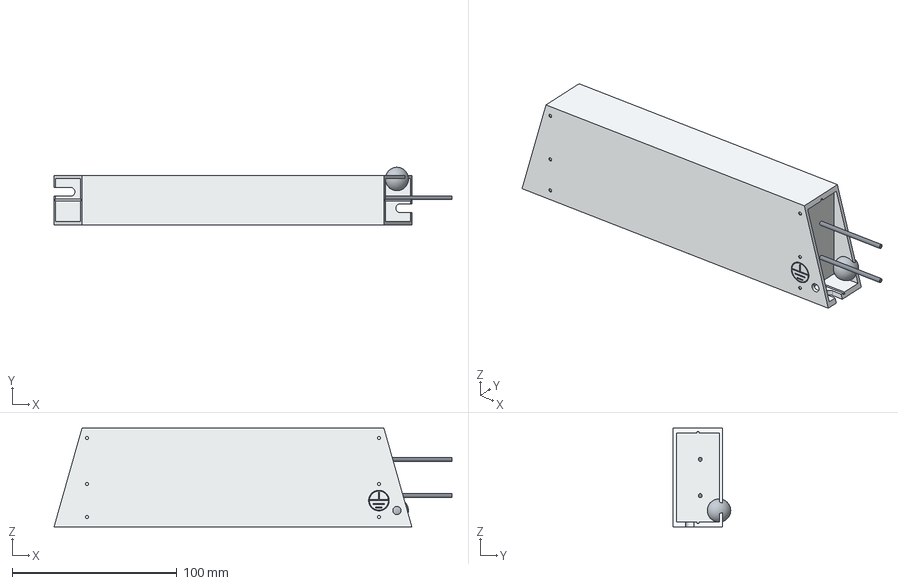
[picture p42: CAD file, 2026-04-04]
Enclsoure_CAD/3dfindit-SIEMENS-JJY_023151720007-22026032702052270251445d0b6156e/JJY_023151720007.stp
241.3 x 34.9 x 60.0 mm
