AetheRZX/MECH_458/Enclsoure_CAD/6SL3246-0BA22-1FA0_3D_en.STP

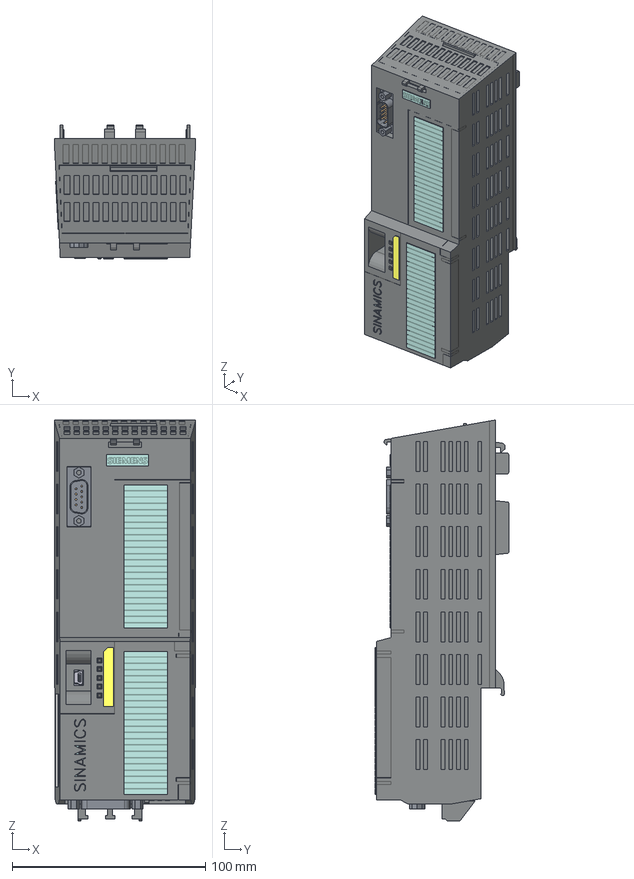
[picture p43: CAD file, 2026-04-04]
Enclsoure_CAD/6SL3246-0BA22-1FA0_3D_en.STP
73.0 x 69.1 x 207.4 mm
