AetheRZX/MECH_458/CAD/2023 V3 -2/2023 V3 -2/L bracket custom.SLDPRT

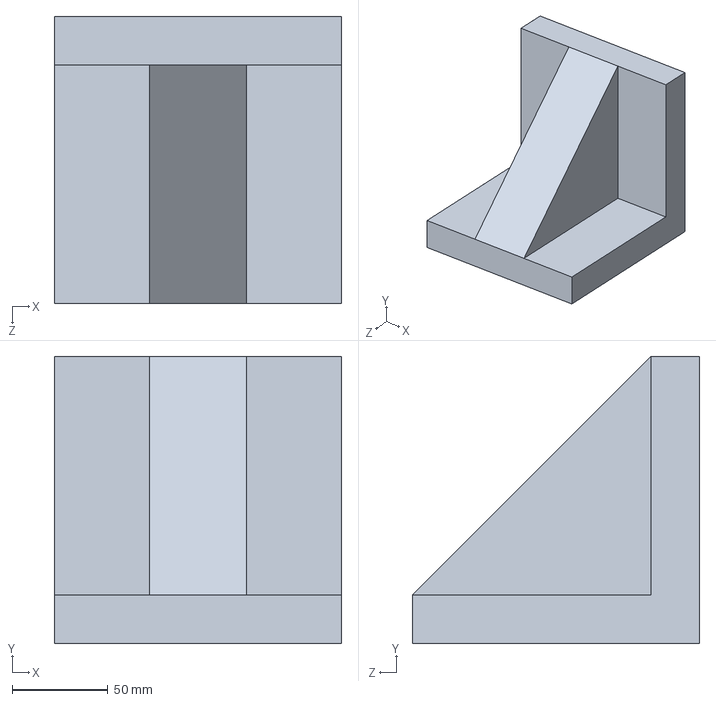
[picture p44: CAD file, 2026-03-04]
CAD/2023 V3 -2/2023 V3 -2/L bracket custom.SLDPRT
150.0 x 150.0 x 150.0 mm
