AetheRZX/MECH_458/CAD/Tabletop_Mock/aluminum_sheet.SLDPRT

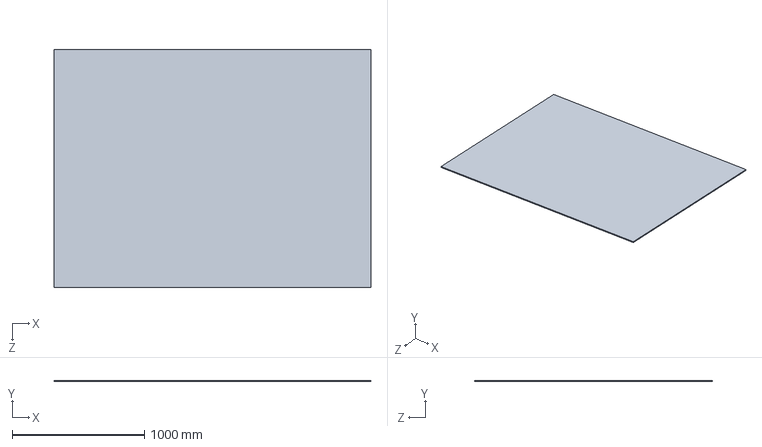
[picture p45: CAD file, 2026-03-04]
CAD/Tabletop_Mock/aluminum_sheet.SLDPRT
2400.0 x 10.0 x 1800.0 mm
