AetheRZX/MECH_458/CAD/WoodenFrameDesign.STEP

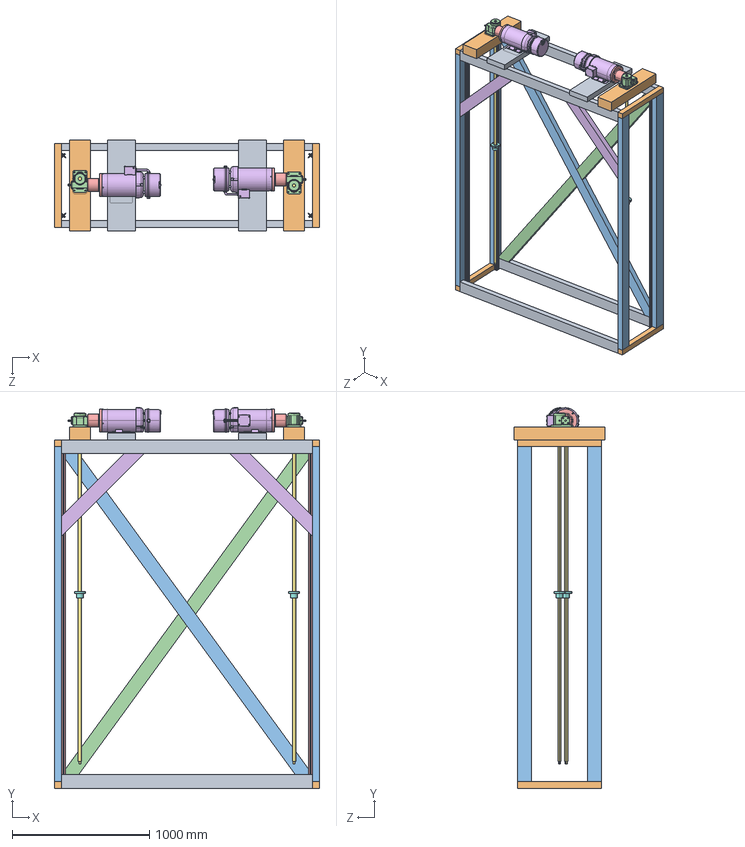
[picture p46: CAD file, 2026-04-04]
CAD/WoodenFrameDesign.STEP
1930.4 x 2774.9 x 660.4 mm
Bottom Length Pieces^WoodenFrameDesign x 2
Bottom Width Pieces^WoodenFrameDesign x 2
Vertical Pieces^WoodenFrameDesign
2.5-MSJ-IR-MM-SSE92.3192.31.stp x 2
2.5-MSJX05.stp x 2
20LT.stp x 2
2.5-MSJ-IR92.3192.31urir_ls.stp x 2
2.5-MSJ-IRmsj_i.stp x 2
Motor Mount^WoodenFrameDesign x 2
Blue Motor Mount^WoodenFrameDesign x 2
Cross Bracing^WoodenFrameDesign
Cross Bracing #2^WoodenFrameDesign
8ft Extrusion_5537T743 x 4
Gussets^WoodenFrameDesign
