AetheRZX/MECH_458/Enclsoure_CAD/VZ1000-11-1-12_JSY3000.stp

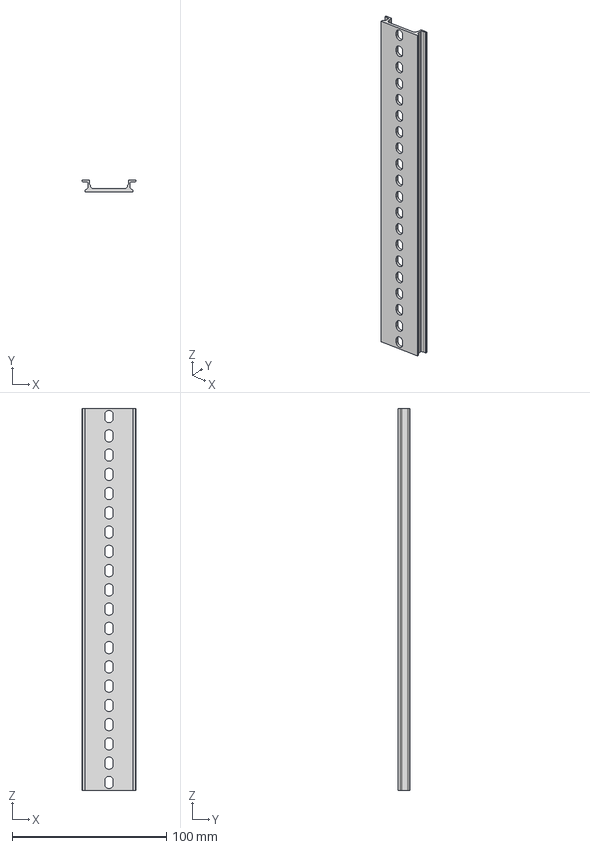
[picture p47: CAD file, 2026-04-04]
Enclsoure_CAD/VZ1000-11-1-12_JSY3000.stp
35.0 x 7.50 x 248.0 mm
