AetheRZX/MECH_458/CAD/2023 V3 -2/2023 V3 -2/shaft table.SLDPRT

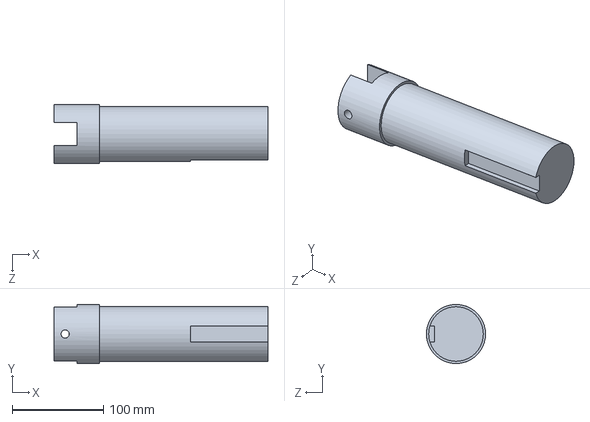
[picture p48: CAD file, 2026-03-04]
CAD/2023 V3 -2/2023 V3 -2/shaft table.SLDPRT
235.0 x 65.0 x 65.0 mm
