AetheRZX/MECH_458/CAD/2025 Solidworks/2025 SOLIDWORKS/Nexen-970563.step

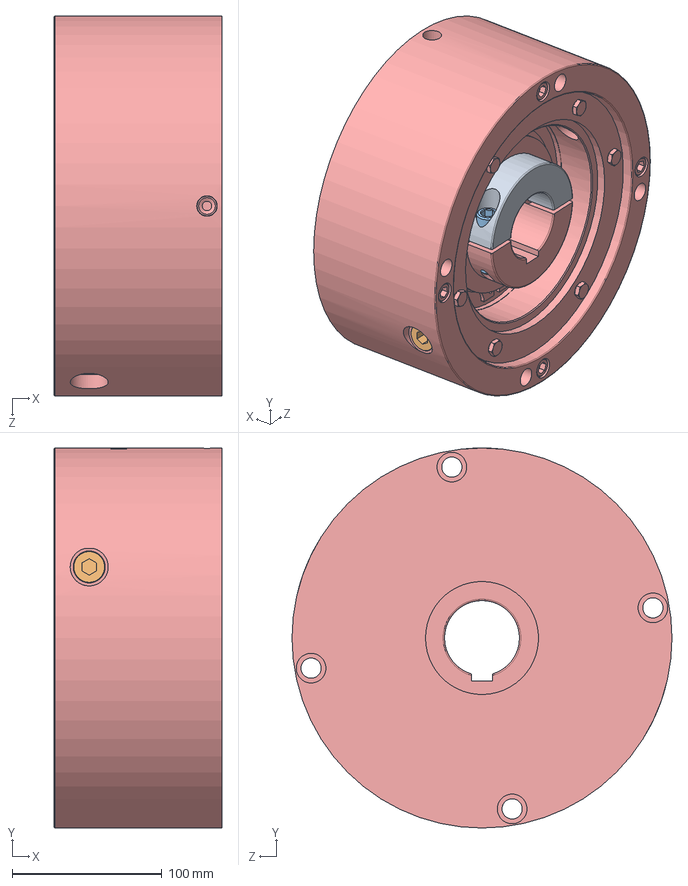
[picture p49: CAD file, 2026-01-17]
CAD/2025 Solidworks/2025 SOLIDWORKS/Nexen-970563.step
112.2 x 254.0 x 254.0 mm
