AetheRZX/MECH_458/CAD/Supplier/VFD/GS21-22P0.STEP

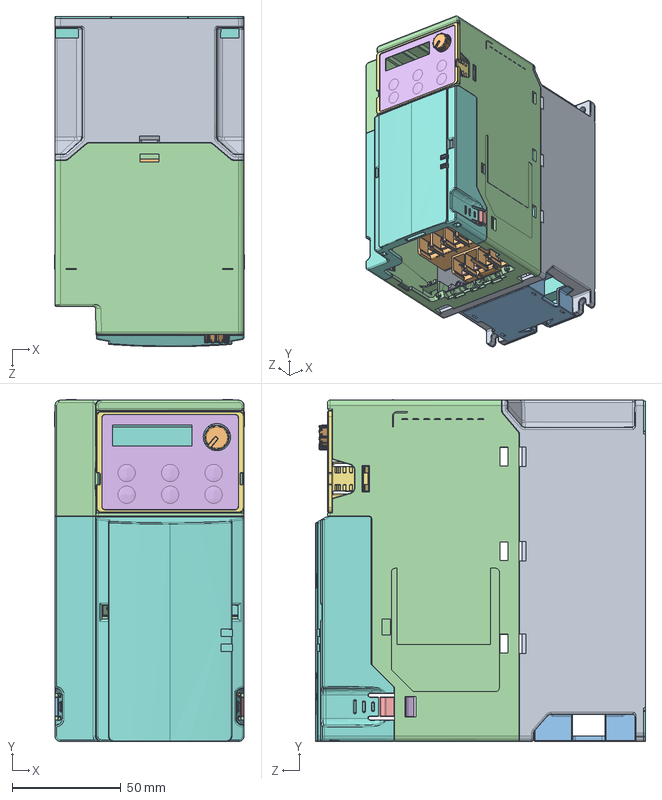
[picture p50: CAD file, 2026-03-04]
CAD/Supplier/VFD/GS21-22P0.STEP
87.6 x 157.3 x 152.0 mm
