AetheRZX/MECH_458/CAD/Tabletop_Mock/shaft.SLDPRT

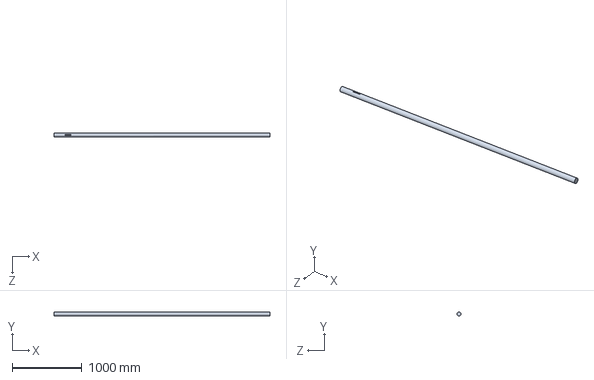
[picture p51: CAD file, 2026-03-04]
CAD/Tabletop_Mock/shaft.SLDPRT
3100.0 x 60.0 x 60.0 mm
