AetheRZX/MECH_458/CAD/2023 V3 -2/2023 V3 -2/Platformbrake.SLDPRT

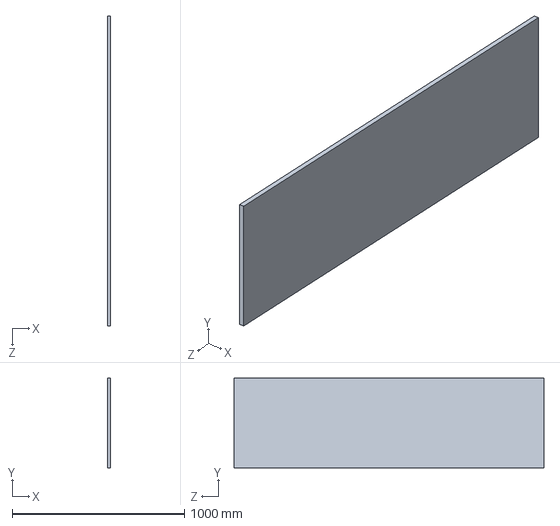
[picture p52: CAD file, 2026-03-04]
CAD/2023 V3 -2/2023 V3 -2/Platformbrake.SLDPRT
20.0 x 520.0 x 1800.0 mm
