AetheRZX/MECH_458/CAD/Rotational 2023 V3/2023 V3/Coupling.SLDPRT

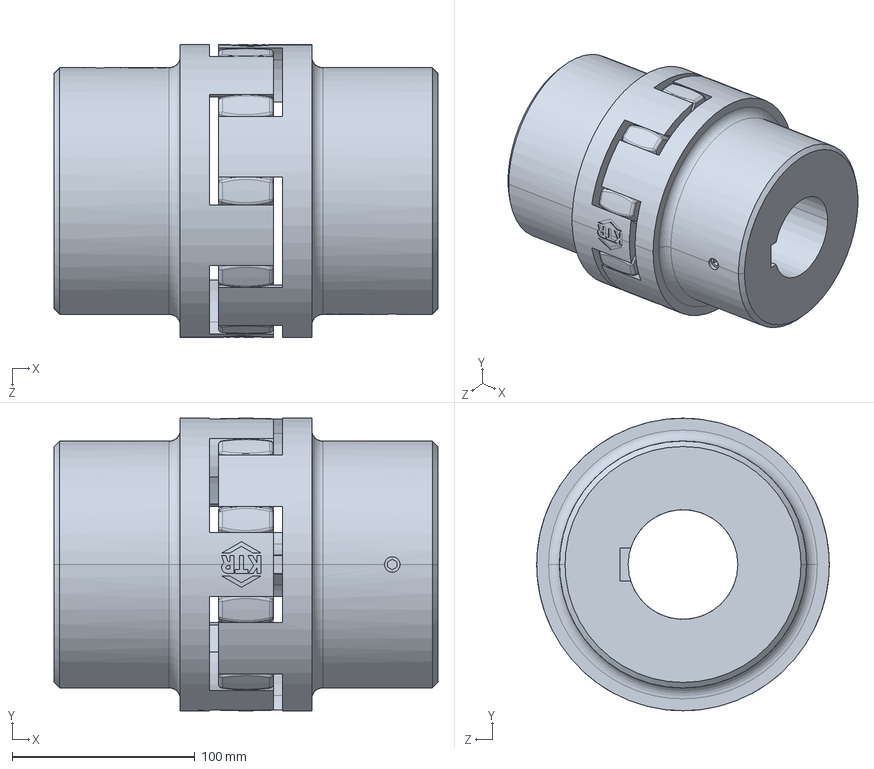
[picture p53: CAD file, 2026-03-04]
CAD/Rotational 2023 V3/2023 V3/Coupling.SLDPRT
210.0 x 160.0 x 160.0 mm
