AetheRZX/MECH_458/CAD/tabletop simple.SLDPRT

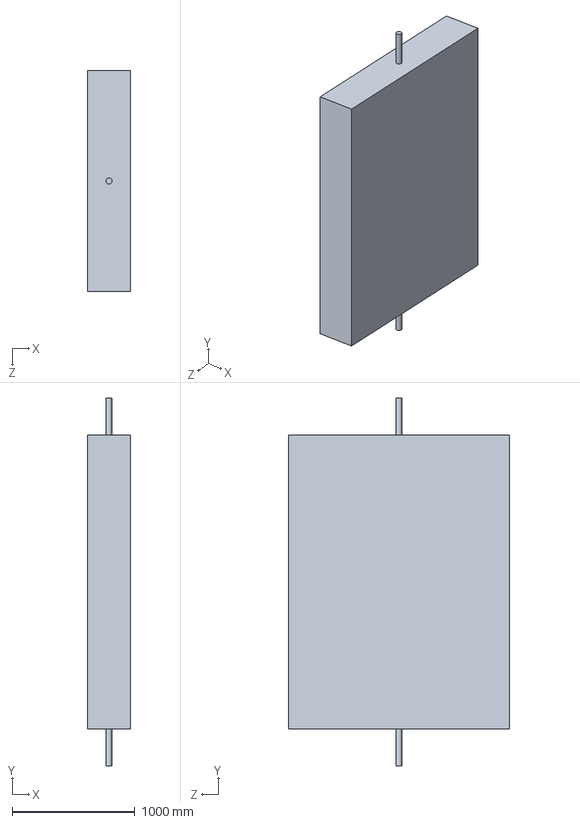
[picture p54: CAD file, 2026-03-04]
CAD/tabletop simple.SLDPRT
350.0 x 3000.0 x 1800.0 mm
