AetheRZX/MECH_458/CAD/Tabletop_Mock/flange.SLDPRT

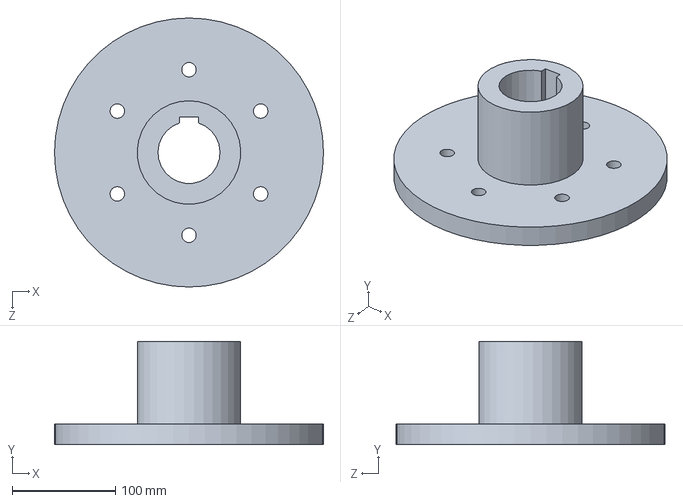
[picture p55: CAD file, 2026-03-04]
CAD/Tabletop_Mock/flange.SLDPRT
260.0 x 100.0 x 260.0 mm
