AetheRZX/MECH_458/CAD/pillow block bearings.SLDPRT

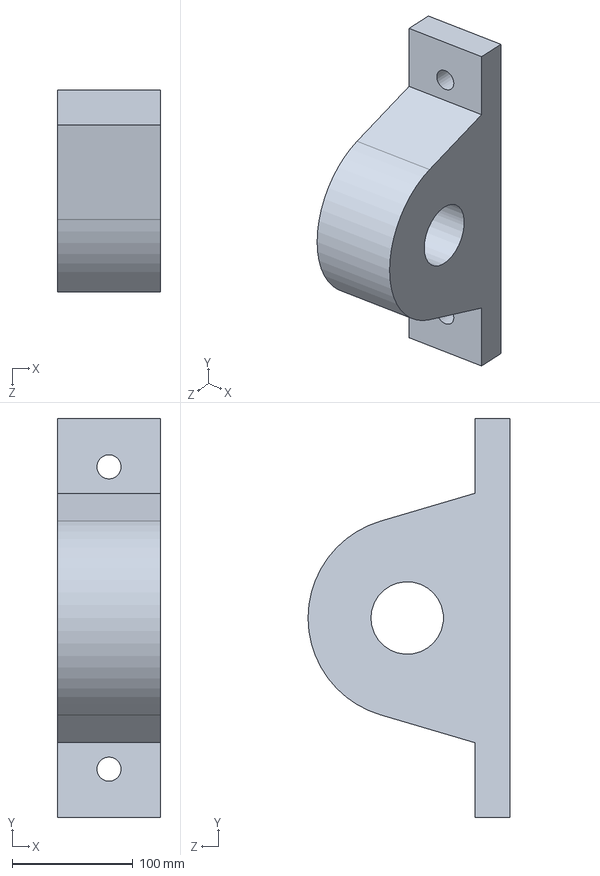
[picture p56: CAD file, 2026-03-04]
CAD/pillow block bearings.SLDPRT
85.0 x 330.0 x 167.0 mm
