AetheRZX/MECH_458/CAD/Tabletop_Mock/key_18x11x90.SLDPRT

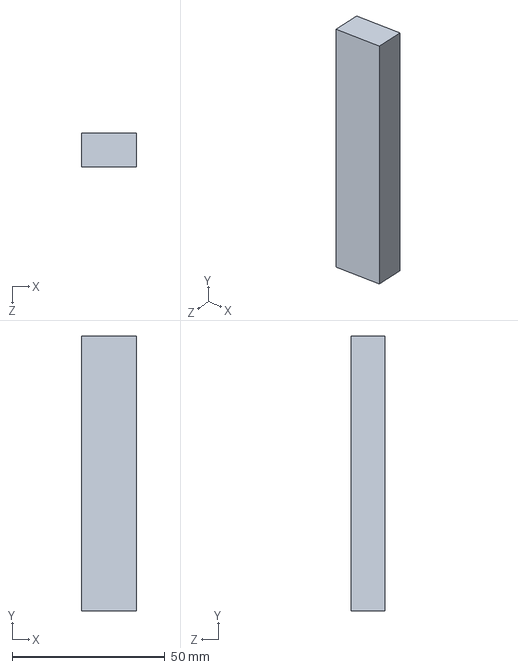
[picture p57: CAD file, 2026-03-04]
CAD/Tabletop_Mock/key_18x11x90.SLDPRT
18.0 x 90.0 x 11.0 mm
