AetheRZX/MECH_458/CAD/2023 SW/Key.SLDPRT

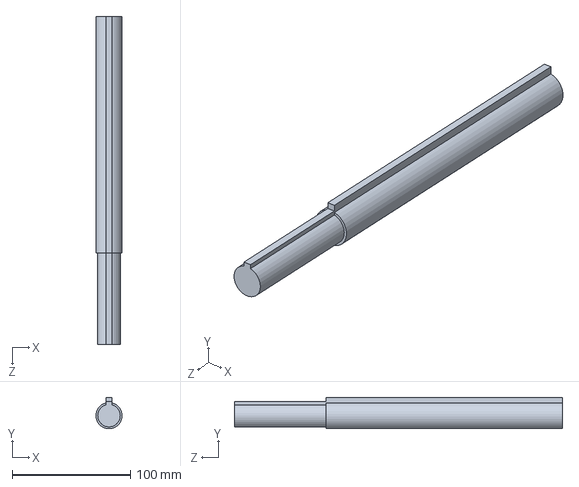
[picture p58: CAD file, 2026-01-17]
CAD/2023 SW/Key.SLDPRT
22.2 x 26.6 x 277.5 mm
