AetheRZX/MECH_458/CAD/2023 V3 -2/2023 V3 -2/bearing support.SLDPRT

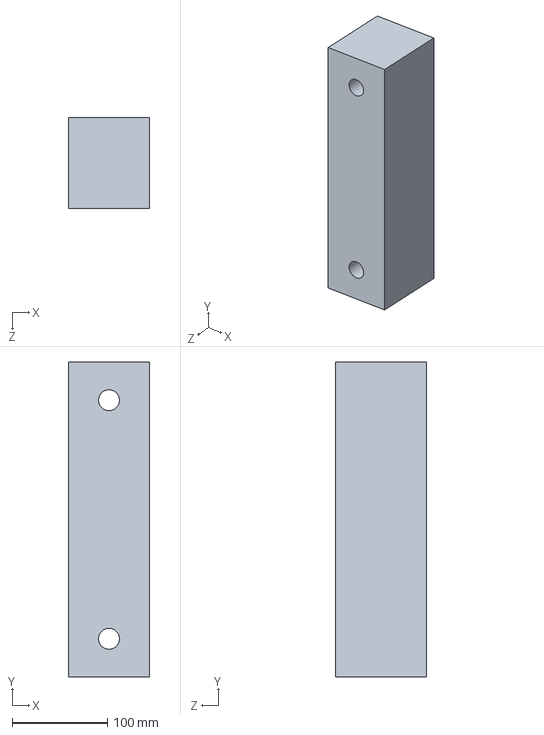
[picture p59: CAD file, 2026-03-04]
CAD/2023 V3 -2/2023 V3 -2/bearing support.SLDPRT
85.0 x 330.0 x 95.0 mm
