AetheRZX/MECH_458/CAD/Platform.SLDPRT

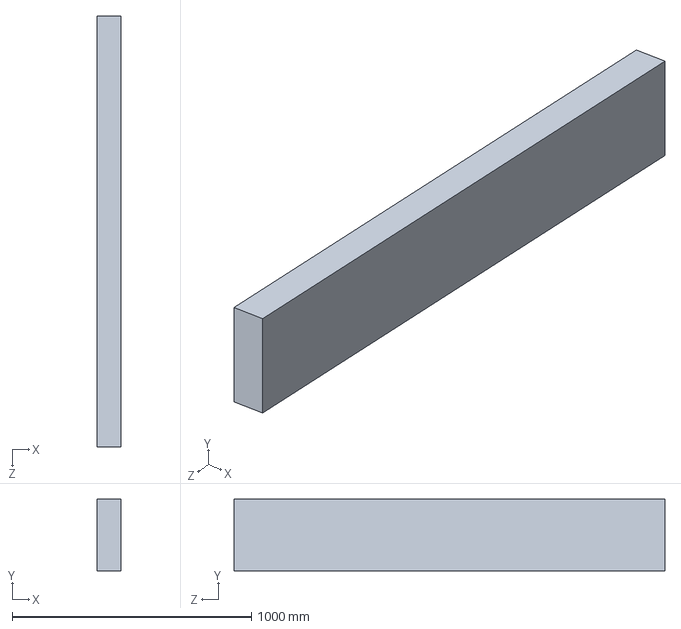
[picture p60: CAD file, 2026-03-04]
CAD/Platform.SLDPRT
100.0 x 300.0 x 1800.0 mm
