AetheRZX/MECH_458/CAD/Tabletop_Mock/weld_hub_60mm.SLDPRT

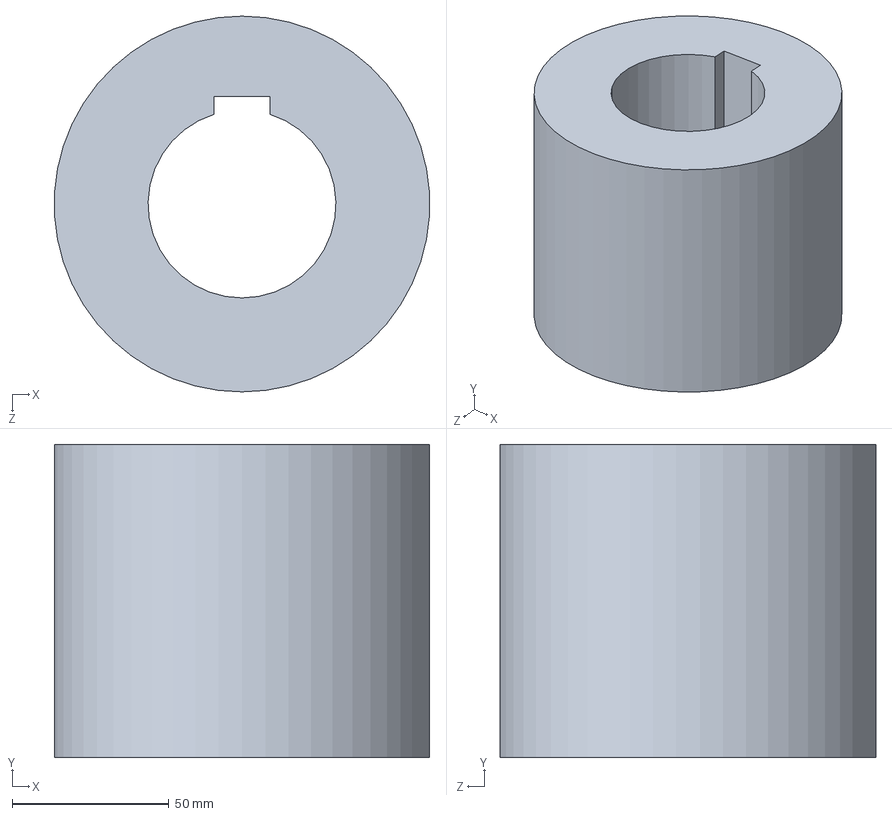
[picture p61: CAD file, 2026-03-04]
CAD/Tabletop_Mock/weld_hub_60mm.SLDPRT
119.8 x 100.0 x 120.0 mm
