AetheRZX/MECH_458/CAD/2023 SW/Slew drive bracket.SLDPRT

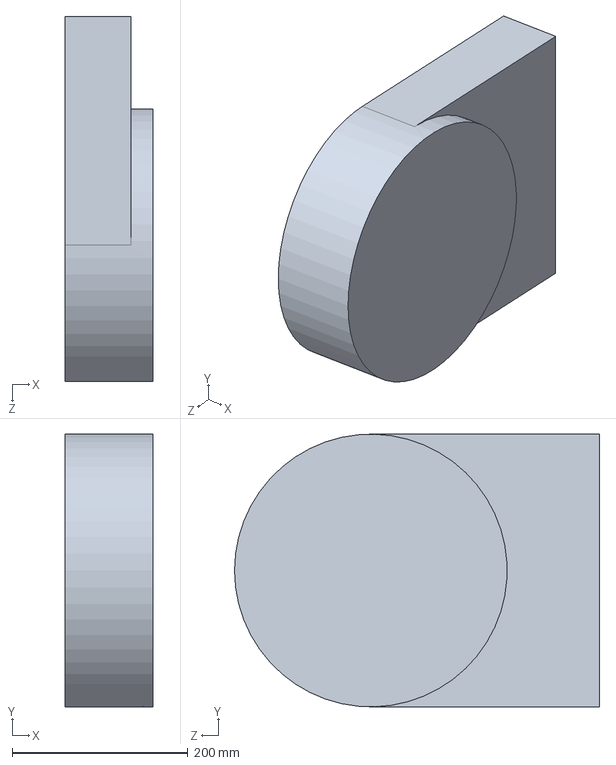
[picture p62: CAD file, 2026-01-17]
CAD/2023 SW/Slew drive bracket.SLDPRT
100.4 x 310.0 x 415.0 mm
