AetheRZX/MECH_458/CAD/nord motor rotation cad.stp

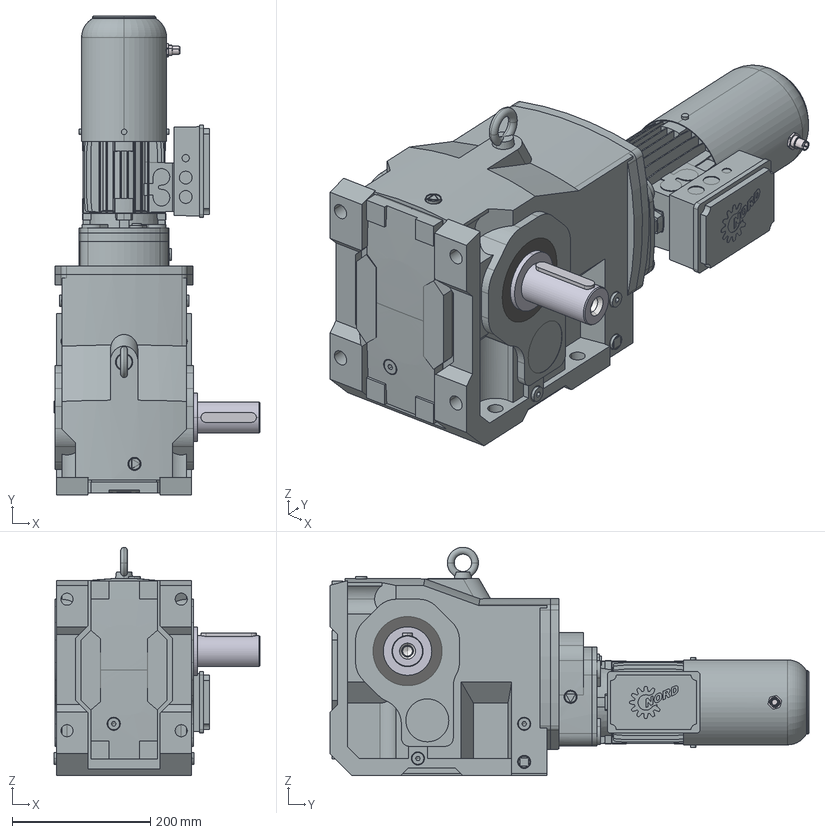
[picture p63: CAD file, 2026-03-04]
CAD/nord motor rotation cad.stp
297.0 x 691.9 x 330.0 mm
