AetheRZX/MECH_458/CAD/Rotational 2023 V3/2023 V3/Brake bracket.SLDPRT

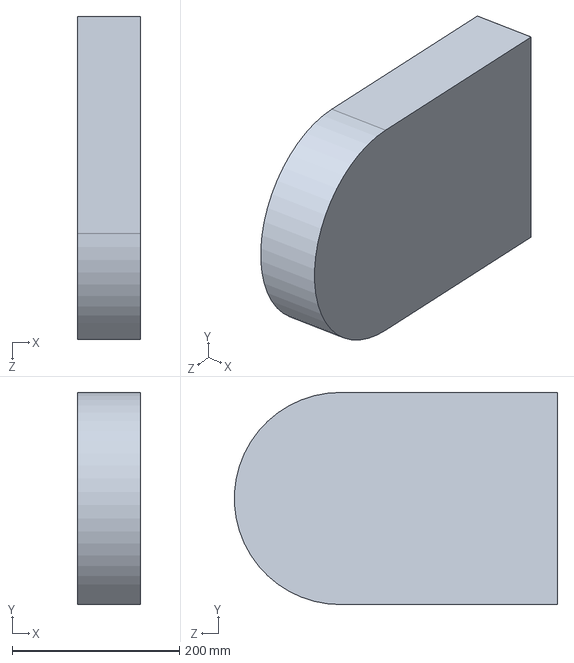
[picture p64: CAD file, 2026-03-04]
CAD/Rotational 2023 V3/2023 V3/Brake bracket.SLDPRT
75.0 x 254.0 x 386.7 mm
