AetheRZX/MECH_458/CAD/2023 SW/motor brushless.SLDPRT

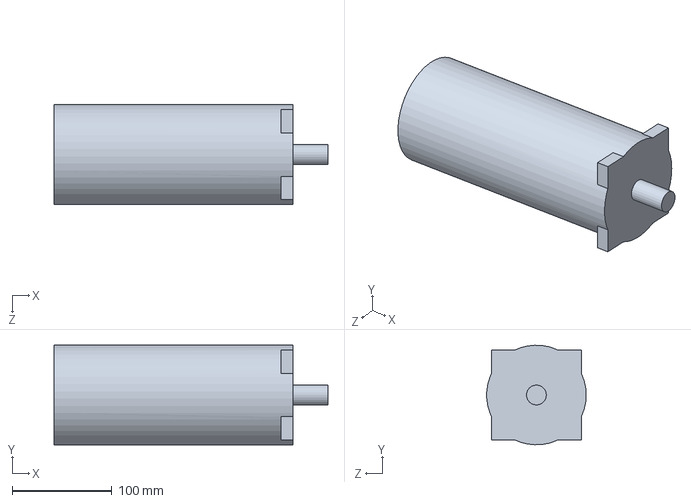
[picture p65: CAD file, 2026-01-17]
CAD/2023 SW/motor brushless.SLDPRT
275.0 x 99.9 x 99.9 mm
