AetheRZX/MECH_458/CAD/2023 SW/Worm gear.SLDPRT

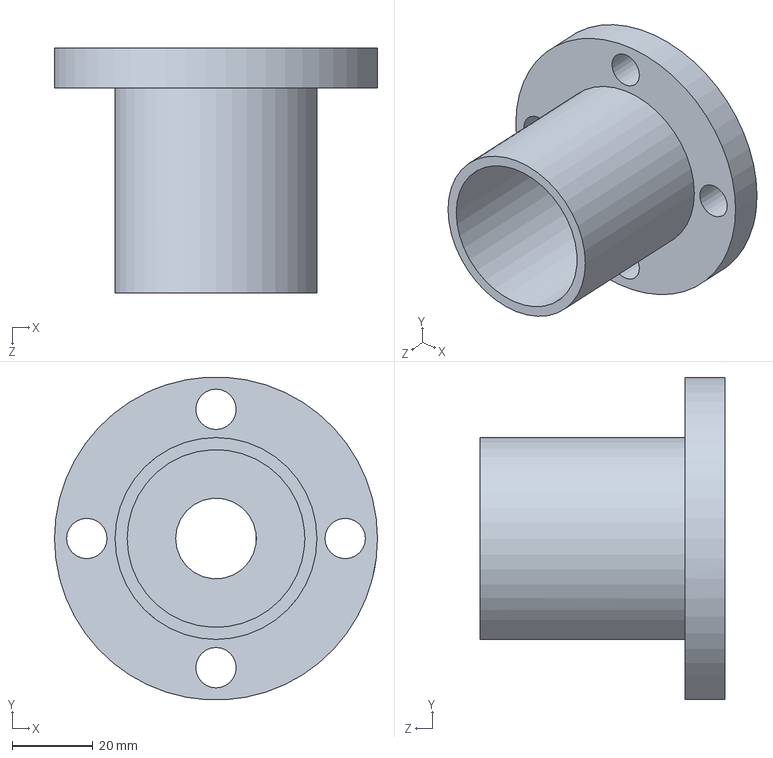
[picture p66: CAD file, 2026-01-17]
CAD/2023 SW/Worm gear.SLDPRT
80.0 x 79.8 x 60.8 mm
