AetheRZX/MECH_458/CAD/2023 V3 -2/2023 V3 -2/NordMotor.SLDPRT

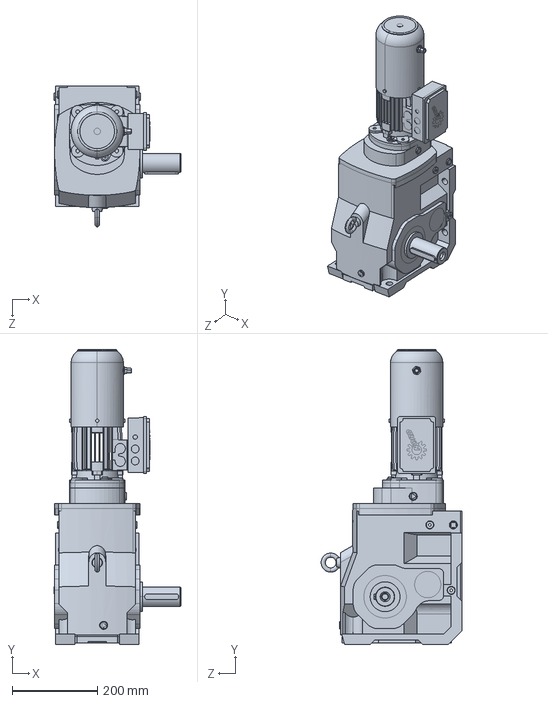
[picture p67: CAD file, 2026-03-04]
CAD/2023 V3 -2/2023 V3 -2/NordMotor.SLDPRT
297.0 x 691.9 x 330.0 mm
