AetheRZX/MECH_458/CAD/2023 SW/Mounter.SLDPRT

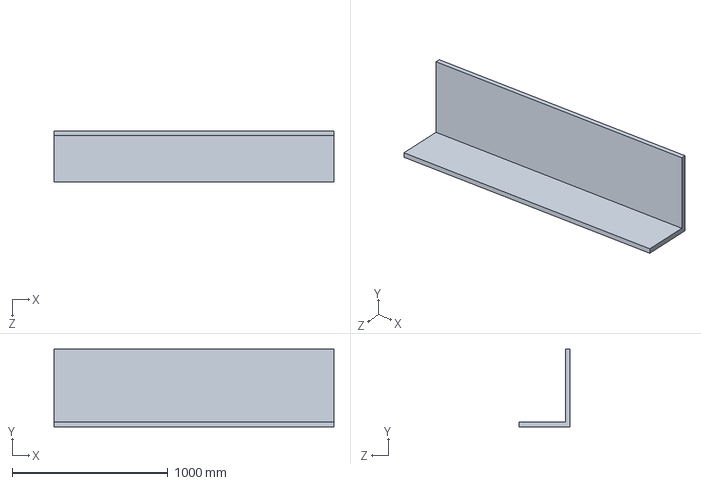
[picture p68: CAD file, 2026-01-17]
CAD/2023 SW/Mounter.SLDPRT
1800.0 x 500.0 x 330.0 mm
