AetheRZX/MECH_458/CAD/2023 SW/RKE314-X04-RI.STEP

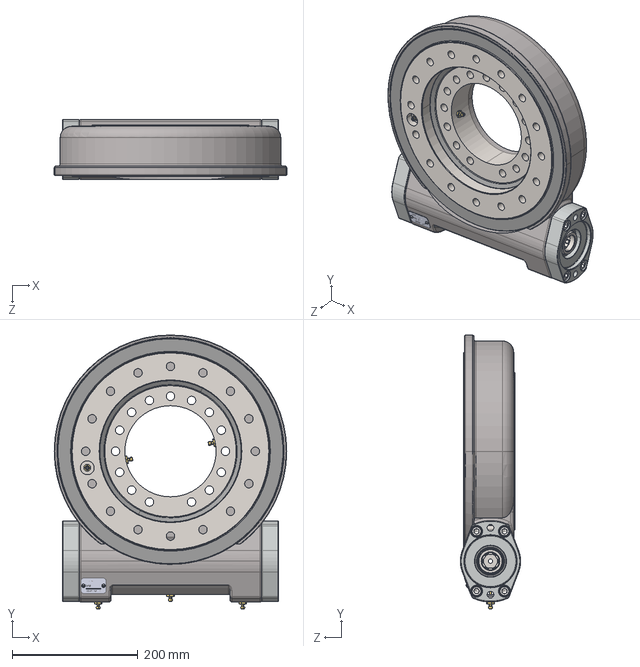
[picture p69: CAD file, 2026-01-17]
CAD/2023 SW/RKE314-X04-RI.STEP
370.0 x 436.0 x 96.0 mm
