AetheRZX/MECH_458/CAD/2023 SW/Brace.SLDPRT

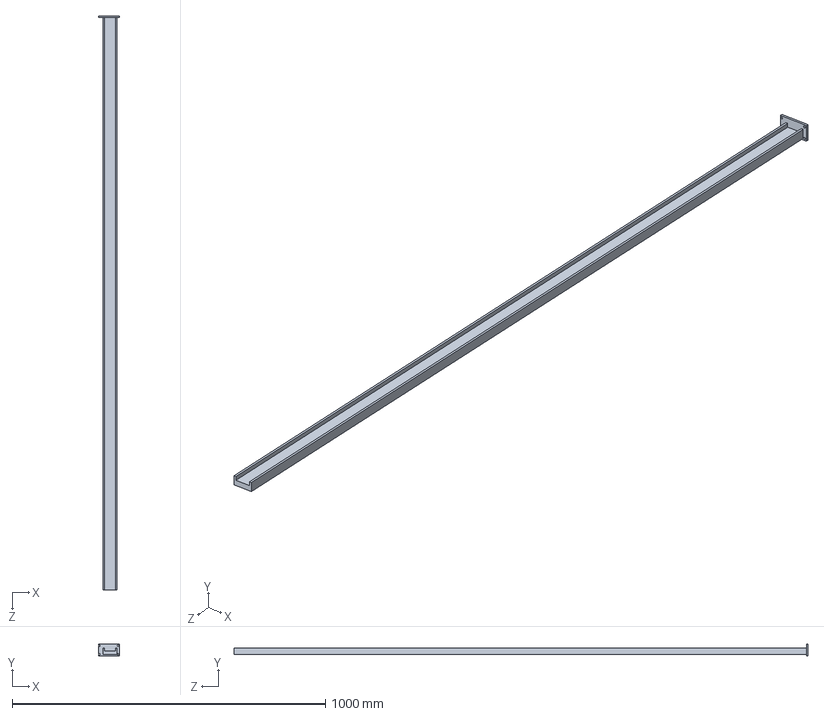
[picture p70: CAD file, 2026-01-17]
CAD/2023 SW/Brace.SLDPRT
67.4 x 36.9 x 1833.0 mm
