AetheRZX/MECH_458/CAD/2023 SW/Base.SLDPRT

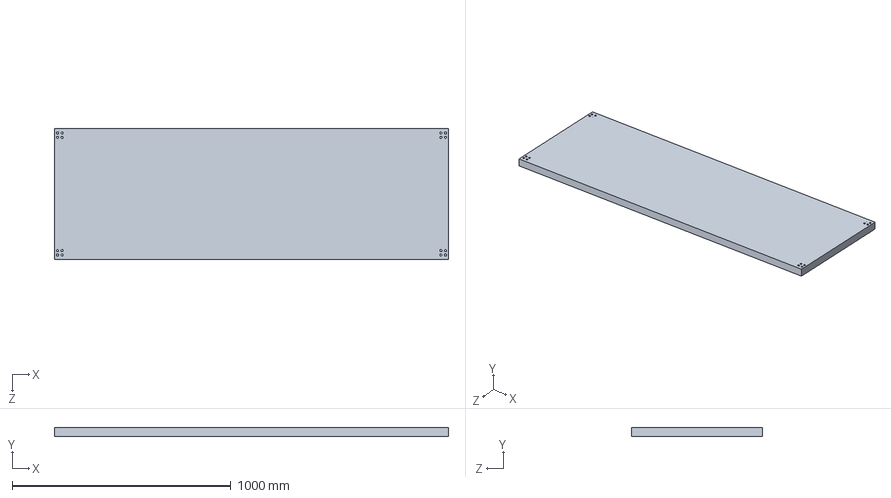
[picture p71: CAD file, 2026-01-17]
CAD/2023 SW/Base.SLDPRT
1800.0 x 40.0 x 600.0 mm
