AetheRZX/MECH_458/CAD/2023 SW/motor coupling.SLDPRT

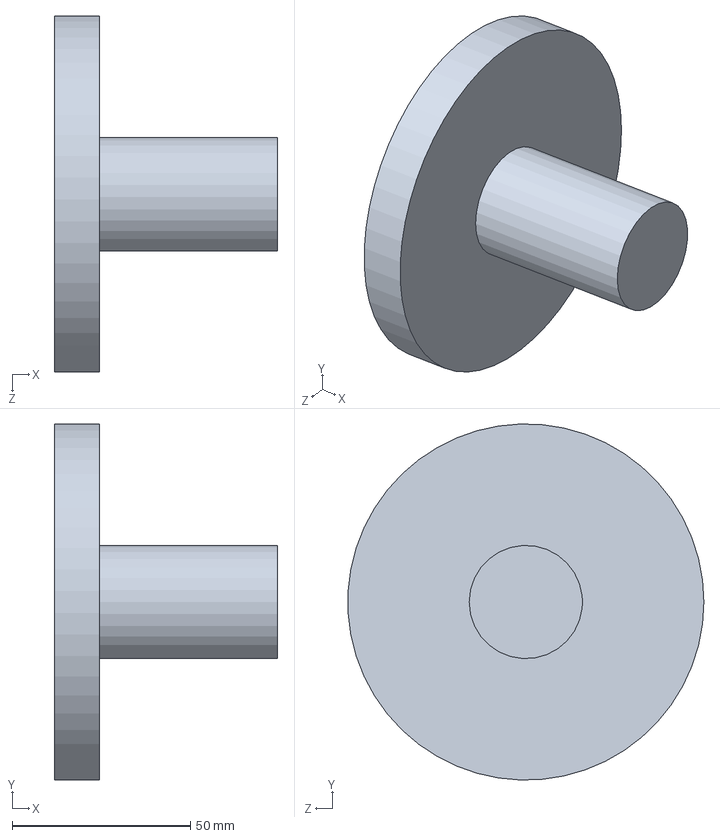
[picture p72: CAD file, 2026-01-17]
CAD/2023 SW/motor coupling.SLDPRT
62.7 x 100.0 x 99.9 mm
