AetheRZX/MECH_458/CAD/2025 Solidworks/2025 SOLIDWORKS/Assembly.SLDASM

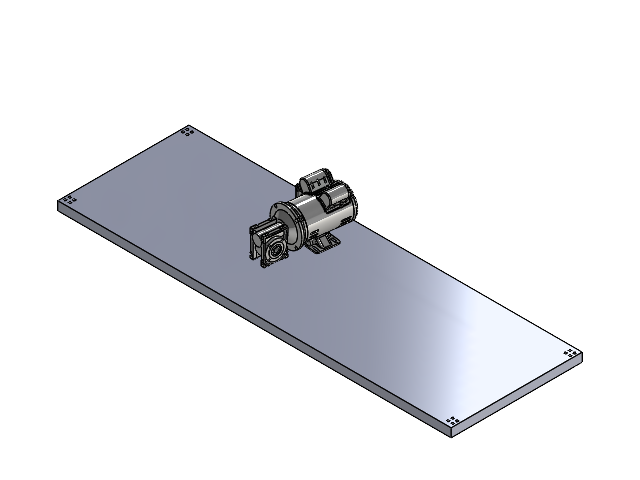
[picture p73: CAD file, 2026-01-17]
CAD/2025 Solidworks/2025 SOLIDWORKS/Assembly.SLDASM
Base
6771K413_Flexible-Mount Right-Angle Speed Reducer
7014N33_Base-Mount AC Motors
