AetheRZX/MECH_458/Poster/CAD_files and pics/Wooden Assembly Actual #2/Wooden Assembly Actual.SLDASM

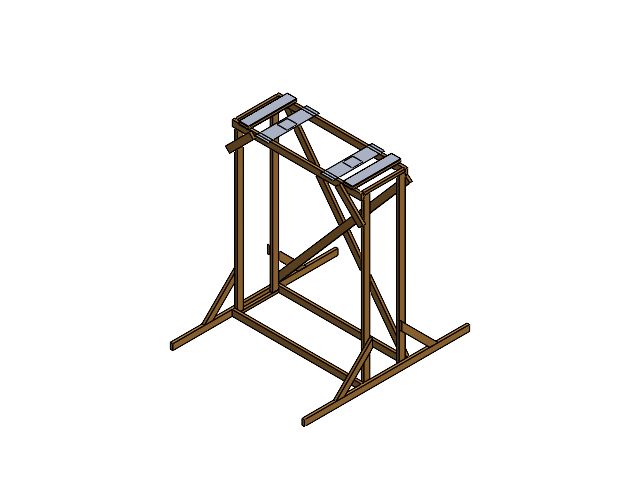
[picture p74: CAD file, 2026-04-04]
Poster/CAD_files and pics/Wooden Assembly Actual #2/Wooden Assembly Actual.SLDASM
Bottom Frame^Wooden Assembly Actual x 2
Bottom Frame Width^Wooden Assembly Actual x 2
Vertical Supports^Wooden Assembly Actual
Gear Box Mount^Wooden Assembly Actual
Gussets^Wooden Assembly Actual
Metal Blue Motor Mount^Blue Motor Mount Assem_Wooden Assembly Actual
Blue Motor Mount Sandwich^Blue Motor Mount Assem_Wooden Assembly Actual
Metal Sandwich Blue Motor Moutn^Blue Motor Mount Assem_Wooden Assembly Actual
Cross Brace #1^Wooden Assembly Actual
Cross Brace #2^Wooden Assembly Actual
Horizontal Cross Brace^Wooden Assembly Actual x 2
Angled Cross Brace^Wooden Assembly Actual x 2
