AetheRZX/MECH_458/CAD/2023 SW/Assembly_v1.SLDASM

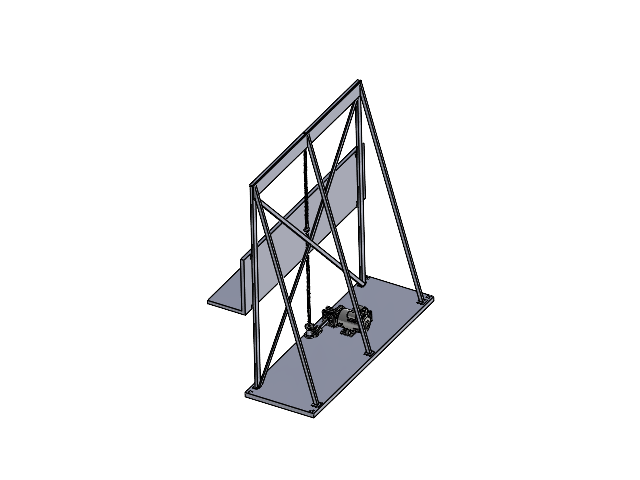
[picture p75: CAD file, 2026-03-04]
CAD/2023 SW/Assembly_v1.SLDASM
Base
7014N33_Base-Mount AC Motors
6771K413_Flexible-Mount Right-Angle Speed Reducer
Key
57545K227_Metal Worm
Worm gear
99030A109_1018 Carbon Steel Precision Acme Lead Screw
9184T814_15 mm Wide x 1600 mm Long Rail Guide Rail for Maintenance-Free Ball Bearing Carriage x 2
9184T101_Maintenance-Free Ball Bearing Carriage x 4
Lead screw nut
Brace x 2
Mounter
2664N384_Metal Gear - 20 Degree Pressure Angle
Part2^Assembly_v1
Part3^Assembly_v1
Part10^Assembly_v1 x 3
Part13^Assembly_v1
Part14^Assembly_v1
Part15^Assembly_v1
Part16^Assembly_v1
