AetheRZX/MECH_458/CAD/Frame/Wooden Assembly Actual/Wooden Assembly Actual.SLDASM

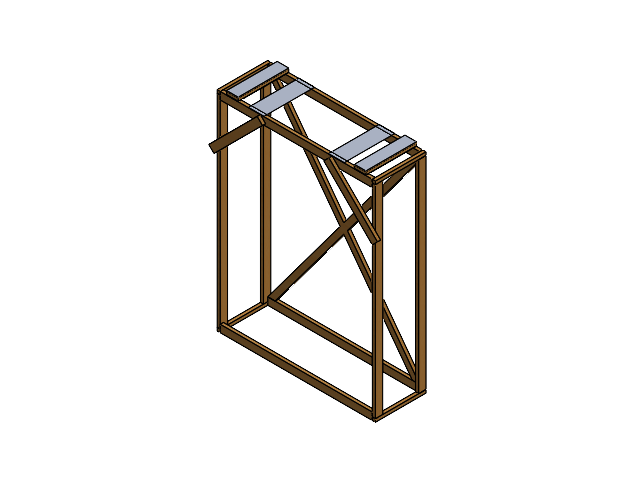
[picture p76: CAD file, 2026-04-04]
CAD/Frame/Wooden Assembly Actual/Wooden Assembly Actual.SLDASM
Bottom Frame^Wooden Assembly Actual x 2
Bottom Frame Width^Wooden Assembly Actual x 2
Vertical Supports^Wooden Assembly Actual
Gear Box Mount^Wooden Assembly Actual
Gussets^Wooden Assembly Actual
Cross Bracing^Wooden Assembly Actual
Metal Blue Motor Mount^Blue Motor Mount Assem_Wooden Assembly Actual
Blue Motor Mount Sandwich^Blue Motor Mount Assem_Wooden Assembly Actual
Metal Sandwich Blue Motor Moutn^Blue Motor Mount Assem_Wooden Assembly Actual
