AetheRZX/MECH_458/CAD/2023 SW/OVERALL ASSEMBLY.SLDASM

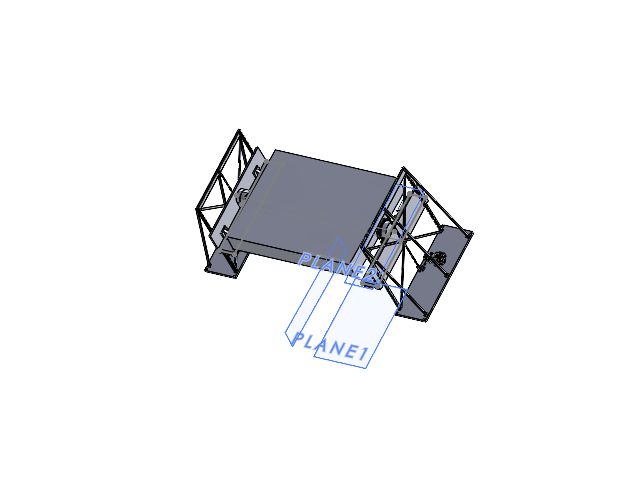
[picture p77: CAD file, 2026-03-04]
CAD/2023 SW/OVERALL ASSEMBLY.SLDASM
Base x 2
7014N33_Base-Mount AC Motors x 2
6771K413_Flexible-Mount Right-Angle Speed Reducer x 2
Key x 2
57545K227_Metal Worm x 2
Worm gear x 2
99030A109_1018 Carbon Steel Precision Acme Lead Screw x 2
9184T814_15 mm Wide x 1600 mm Long Rail Guide Rail for Maintenance-Free Ball Bearing Carriage x 4
9184T101_Maintenance-Free Ball Bearing Carriage x 8
Lead screw nut x 2
Brace x 4
Mounter x 2
2664N384_Metal Gear - 20 Degree Pressure Angle x 2
Part2^Assembly_v1 x 2
Part3^Assembly_v1 x 2
Part10^Assembly_v1 x 6
Part13^Assembly_v1 x 2
Part14^Assembly_v1 x 2
Part15^Assembly_v1 x 2
Part16^Assembly_v1 x 2
Platform x 2
RKE314-X04-RI.step
Nexen-970563.step
L bracket custom x 4
Slew drive bracket
Brake bracket
motor brushless
4208N11_Splined Rotary Shaft
tabletop simple
motor coupling x 2
