AetheRZX/MECH_458/CAD/Rotational 2023 V3/2023 V3/tableassemblykenneth.SLDASM

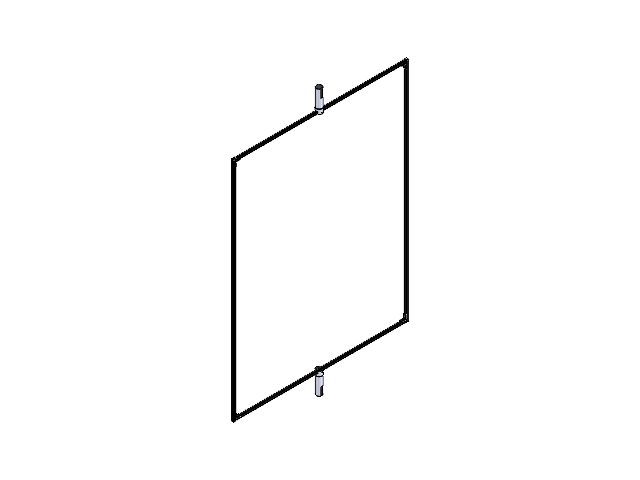
[picture p78: CAD file, 2026-03-04]
CAD/Rotational 2023 V3/2023 V3/tableassemblykenneth.SLDASM
47065T123_T-Slotted Framing(1) x 2
47065T122_T-Slotted Framing x 2
47065T239_Silver Corner Bracket x 4
shaft table x 2
