AetheRZX/MECH_458/CAD/Rotational 2023 V3/2023 V3/Simplified Table.SLDASM

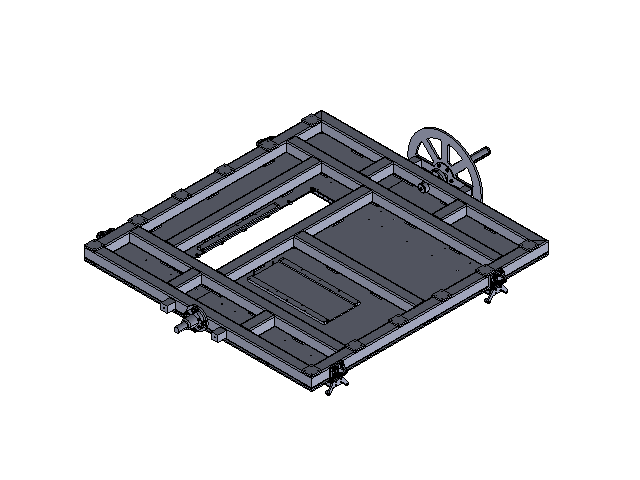
[picture p79: CAD file, 2026-03-04]
CAD/Rotational 2023 V3/2023 V3/Simplified Table.SLDASM
SUB001001256-04.STEP x 2
SUA001005304-01.STEP x 4
SUA001012303-00.STEP x 4
SUA001012305-00.STEP x 4
SUA001005505-00.STEP x 4
SUA001012306-00.STEP x 4
SUA001005503-00.STEP x 4
STA031501755.STEP x 8
Hexagonal Nut_STA005060001.STEP x 8
CHC Screw_STA003050201.STEP x 16
CHC Screw_STA003050161.STEP x 56
BHC Screw_STA003060104.STEP x 40
1061101_2022-03-21_printable.STEP x 2
SUA001002701-02_D_faut_Brut d''usinage_.STEP
SUA002002701-02.STEP
SUA002002702-01.STEP
SUA001002702-01.STEP x 4
SUA032002701-01.STEP
STA050811001.STEP x 4
SUA001002717-00.STEP x 8
SUA001002713-00.STEP
SUA001002714-00.STEP
FHC Screw_STA003080252.STEP x 42
FHC Screw_STA003060252.STEP x 30
SUA014003301-01.STEP
SUA001003301-00.STEP
SUA017003301-00.STEP
Washer.STEP x 16
CHC Screw_STA003100301.STEP x 6
Hexagonal Nut_STA005100001.STEP x 6
CHC Screw_STA003100401.STEP x 2
SUA001003302-00.STEP x 2
CHC Screw_STA003100351.STEP x 2
SUA014003302-01.STEP
SUA014003303-00.STEP
SUA001002719-00.STEP x 4
CHC Screw_STA003080301.STEP x 20
