AetheRZX/MECH_458/CAD/X Axis Assem1.SLDASM

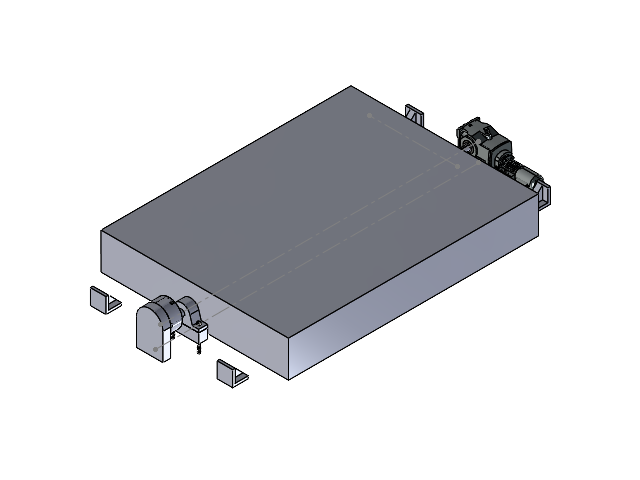
[picture p81: CAD file, 2026-03-04]
CAD/X Axis Assem1.SLDASM
Nexen-970563.step
L bracket custom x 4
Brake bracket
tabletop simple
2026_01_15__01-43-32-059.stp
2026_01_15__01-43-32-049.stp
2026_01_15__01-43-32-039.stp
2026_01_15__01-43-32-029.stp
2026_01_15__01-43-32-019.stp
2026_01_15__01-43-32-009.stp
2026_01_15__01-43-31-999.stp
2026_01_15__01-43-31-989.stp
2026_01_15__01-43-31-979.stp
2026_01_15__01-43-31-969.stp
2026_01_15__01-43-31-949.stp
2026_01_15__01-43-31-939.stp
91290A089_Alloy Steel Socket Head Screw x 2
bearing support
pillow block bearings
91290A072_Alloy Steel Socket Head Screw x 4
