AetheRZX/MECH_458/CAD/2023 V3 -2/2023 V3 -2/X Axis Assem1.SLDASM

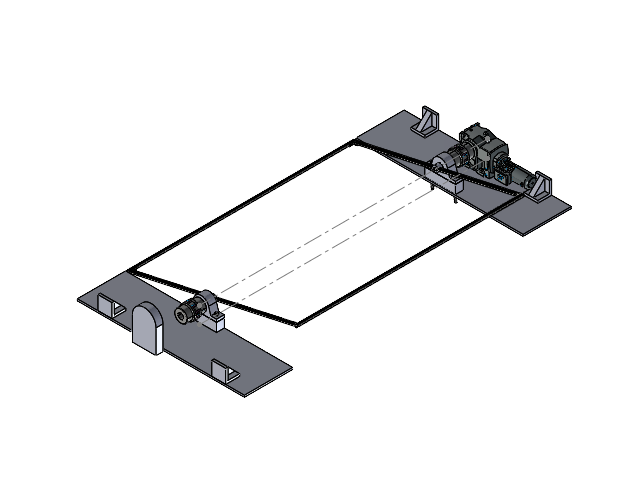
[picture p82: CAD file, 2026-03-04]
CAD/2023 V3 -2/2023 V3 -2/X Axis Assem1.SLDASM
platformdriver
L bracket custom x 4
Brake bracket
91290A089_Alloy Steel Socket Head Screw x 4
bearing support x 2
pillow block bearings x 2
91290A072_Alloy Steel Socket Head Screw x 4
NordMotor
Coupling x 2
47065T123_T-Slotted Framing(1) x 2
47065T122_T-Slotted Framing x 2
47065T239_Silver Corner Bracket x 4
shaft table x 2
Platformbrake
