AetheRZX/MECH_458/(list of files, cad)

Other CAD files:
CAD/2023 V3 -2/2023 V3 -2/Simplified Table.SLDASM
CAD/2023 V3 -2/2023 V3 -2/tableassemblykenneth.SLDASM
CAD/Newport-M-360-90/Newport-M-360-90.sldprt
CAD/2025 Solidworks/2025 SOLIDWORKS/Newport-M-360-90.sldprt
CAD/Rotational 2023 V3/2023 V3/L bracket custom.SLDPRT
Enclsoure_CAD/trendnet-ti-pg160-1.snapshot.4/TI-PG160.SLDPRT
CAD/Rotational 2023 V3/2023 V3/shaft table.SLDPRT
CAD/bearing support.SLDPRT
CAD/2023 V3 -2/2023 V3 -2/Coupling.SLDPRT
CAD/Rotational 2023 V3/2023 V3/pillow block bearings.SLDPRT
CAD/2023 V3 -2/2023 V3 -2/Brake bracket.SLDPRT
CAD/Brake bracket.SLDPRT
CAD/2023 SW/Platform.SLDPRT
CAD/L bracket custom.SLDPRT
CAD/Rotational 2023 V3/2023 V3/Platformbrake.SLDPRT
CAD/2023 SW/L bracket custom.SLDPRT
CAD/2023 V3 -2/2023 V3 -2/platformdriver.SLDPRT
CAD/Rotational 2023 V3/2023 V3/platformdriver.SLDPRT
CAD/Rotational 2023 V3/2023 V3/bearing support.SLDPRT
CAD/2023 SW/Brake bracket.SLDPRT
CAD/2023 SW/tabletop simple.SLDPRT
CAD/2023 V3 -2/2023 V3 -2/pillow block bearings.SLDPRT
CAD/Rotational 2023 V3/2023 V3/NordMotor.SLDPRT
CAD/2023 SW/2664N384_Metal Gear - 20 Degree Pressure Angle.SLDPRT
CAD/2023 SW/4208N11_Splined Rotary Shaft.SLDPRT
CAD/2023 SW/57545K227_Metal Worm.SLDPRT
CAD/2023 SW/6771K413_Flexible-Mount Right-Angle Speed Reducer.SLDPRT
CAD/2023 SW/7014N33_Base-Mount AC Motors.SLDPRT
CAD/2023 SW/9184T101_Maintenance-Free Ball Bearing Carriage.SLDPRT
CAD/2023 SW/9184T814_15 mm Wide x 1600 mm Long Rail Guide Rail for Maintenance-Free Ball Bearing Carriage.SLDPRT
CAD/2023 SW/99030A109_1018 Carbon Steel Precision Acme Lead Screw.SLDPRT
CAD/2023 SW/Lead screw nut.SLDPRT
CAD/2023 V3 -2/2023 V3 -2/47065T122_T-Slotted Framing.SLDPRT
CAD/2023 V3 -2/2023 V3 -2/47065T123_T-Slotted Framing(1).SLDPRT
CAD/2023 V3 -2/2023 V3 -2/47065T239_Silver Corner Bracket.SLDPRT
CAD/2023 V3 -2/2023 V3 -2/91290A072_Alloy Steel Socket Head Screw.SLDPRT
CAD/2023 V3 -2/2023 V3 -2/91290A089_Alloy Steel Socket Head Screw.SLDPRT
CAD/2025 Solidworks/2025 SOLIDWORKS/57545K613_Shaft-Mounted Worm.SLDPRT
CAD/2025 Solidworks/2025 SOLIDWORKS/57545K793_Metal Worm Gear.SLDPRT
CAD/2025 Solidworks/2025 SOLIDWORKS/Nexen-970563.SLDPRT
CAD/91290A072_Alloy Steel Socket Head Screw.SLDPRT
CAD/91290A089_Alloy Steel Socket Head Screw.SLDPRT
CAD/Frame/Wooden Assembly Actual/Thomson Screw Jack.stp
CAD/Rotational 2023 V3/2023 V3/47065T122_T-Slotted Framing.SLDPRT
CAD/Rotational 2023 V3/2023 V3/47065T123_T-Slotted Framing(1).SLDPRT
CAD/Rotational 2023 V3/2023 V3/47065T239_Silver Corner Bracket.SLDPRT
CAD/Rotational 2023 V3/2023 V3/91290A072_Alloy Steel Socket Head Screw.SLDPRT
CAD/Rotational 2023 V3/2023 V3/91290A089_Alloy Steel Socket Head Screw.SLDPRT
CAD/Supplier/VFD/568610.STEP
CAD/Supplier/VFD/838121.STEP
CAD/nord motor rotation cad.SLDASM
Poster/CAD_files and pics/Wooden Assembly Actual #2/Thomson Screw Jack.stp
