AetheRZX/MECH_458/CFP_arduino/CFP TEST DATA/BE_1kg_Test_1.csv

Time_ms | Target | M1_Pos | M2_Pos | M1_RPM | M2_RPM | PWM1 | PWM2
51 | 0 | 0 | 0 | 0.00 | 0.00 | 0 | 0
102 | 0 | 0 | 0 | 0.00 | 0.00 | 0 | 0
153 | 0 | 0 | 0 | 0.00 | 0.00 | 0 | 0
204 | 0 | 0 | 0 | 0.00 | 0.00 | 0 | 0
255 | 0 | 0 | 0 | 0.00 | 0.00 | 0 | 0
306 | 0 | 0 | 0 | 0.00 | 0.00 | 0 | 0
357 | 0 | 0 | 0 | 0.00 | 0.00 | 0 | 0
408 | 0 | 0 | 0 | 0.00 | 0.00 | 0 | 0
459 | 0 | 0 | 0 | 0.00 | 0.00 | 0 | 0
510 | 0 | 0 | 0 | 0.00 | 0.00 | 0 | 0
561 | 0 | 0 | 0 | 0.00 | 0.00 | 0 | 0
612 | 0 | 0 | 0 | 0.00 | 0.00 | 0 | 0
663 | 0 | 0 | 0 | 0.00 | 0.00 | 0 | 0
714 | 0 | 0 | 0 | 0.00 | 0.00 | 0 | 0
765 | 0 | 0 | 0 | 0.00 | 0.00 | 0 | 0
816 | 0 | 0 | 0 | 0.00 | 0.00 | 0 | 0
867 | 0 | 0 | 0 | 0.00 | 0.00 | 0 | 0
918 | 0 | 0 | 0 | 0.00 | 0.00 | 0 | 0
969 | 0 | 0 | 0 | 0.00 | 0.00 | 0 | 0
1020 | 0 | 0 | 0 | 0.00 | 0.00 | 0 | 0
1071 | 0 | 0 | 0 | 0.00 | 0.00 | 0 | 0
1122 | 0 | 0 | 0 | 0.00 | 0.00 | 0 | 0
1173 | 0 | 0 | 0 | 0.00 | 0.00 | 0 | 0
1224 | 0 | 0 | 0 | 0.00 | 0.00 | 0 | 0
1275 | 0 | 0 | 0 | 0.00 | 0.00 | 0 | 0
1326 | 0 | 0 | 0 | 0.00 | 0.00 | 0 | 0
1377 | 0 | 0 | 0 | 0.00 | 0.00 | 0 | 0
1428 | 0 | 0 | 0 | 0.00 | 0.00 | 0 | 0
1479 | 0 | 0 | 0 | 0.00 | 0.00 | 0 | 0
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
