AetheRZX/MECH_458/Wiring/rotation_wiring.pdf

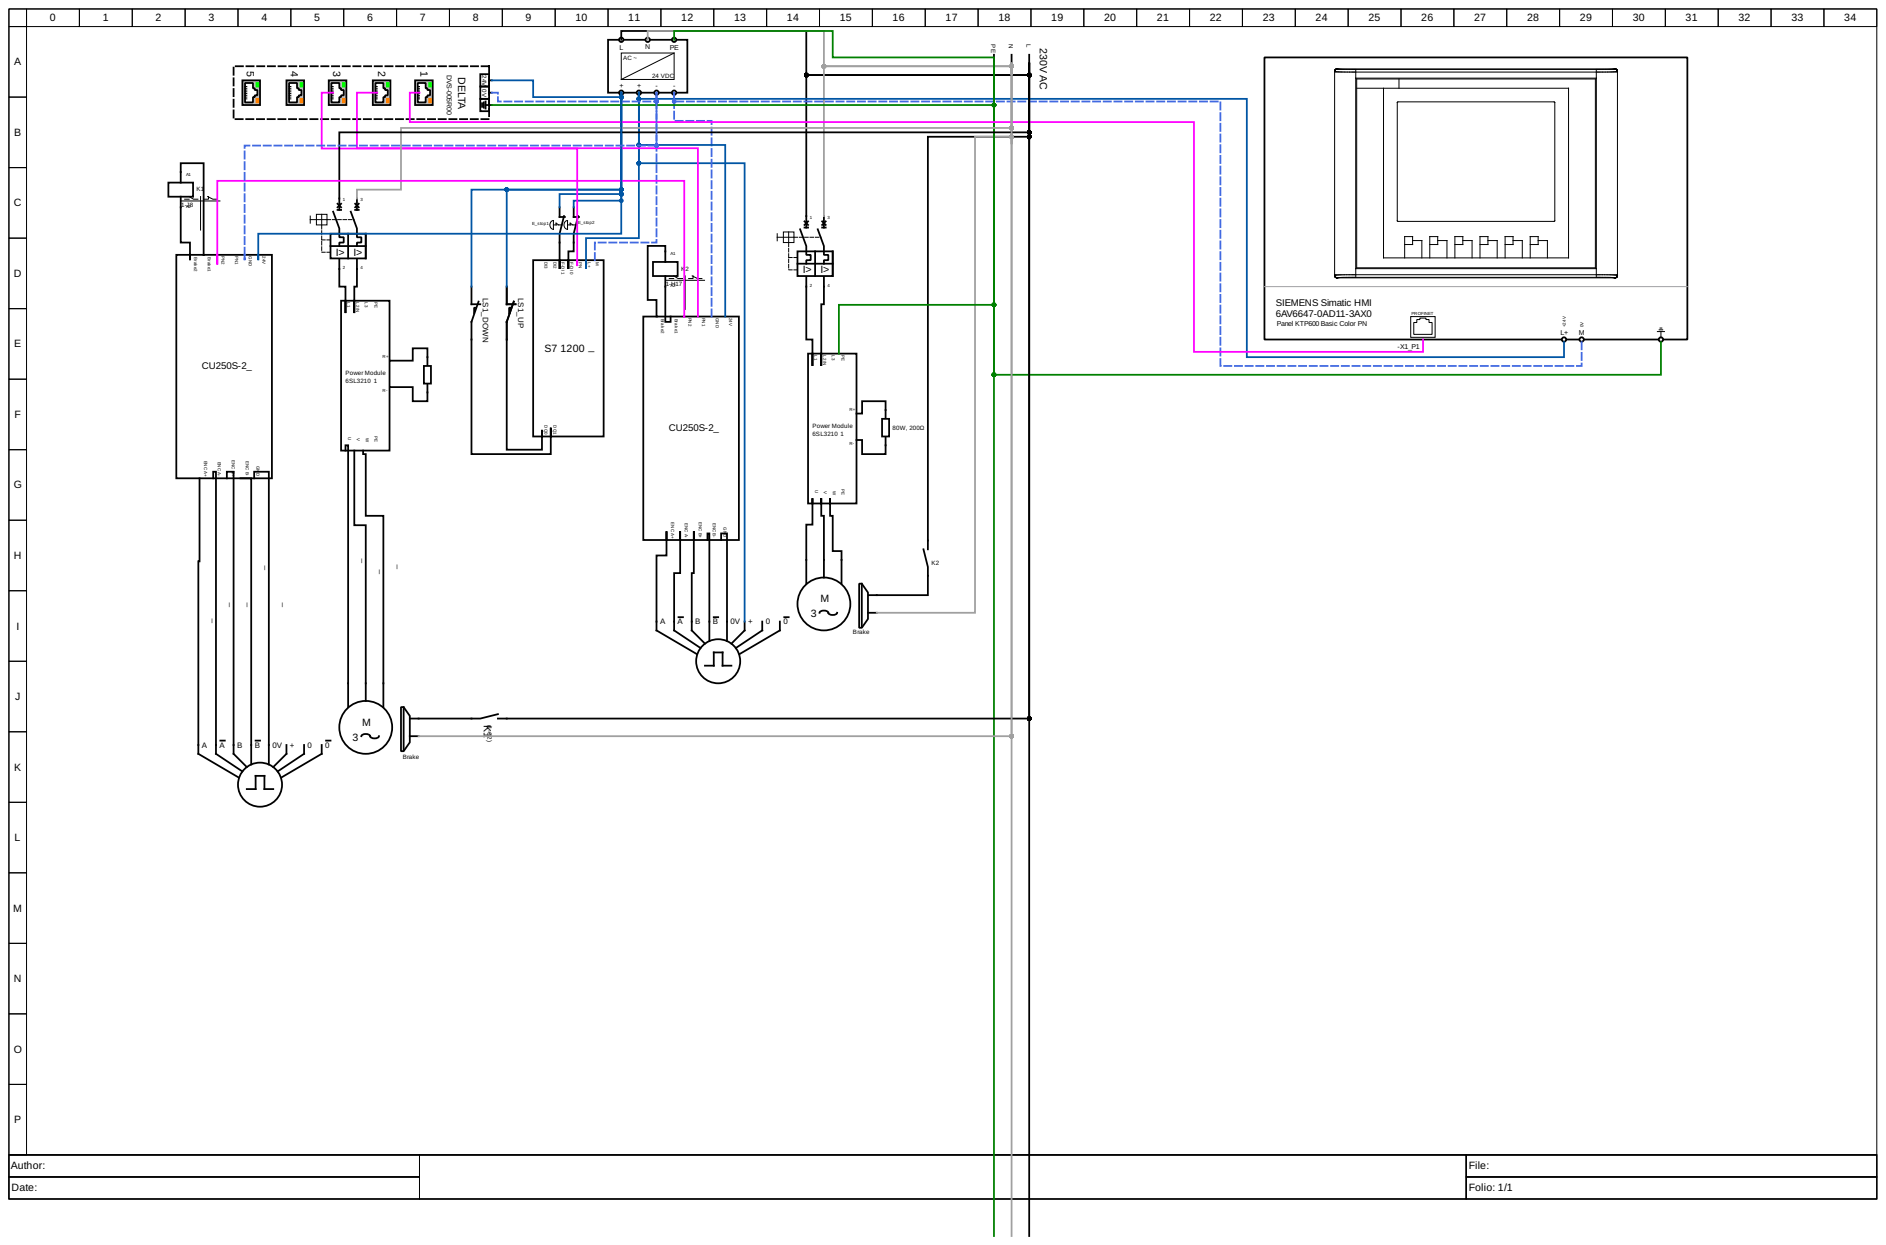
[picture p84: page 1]
Author:; File:; Date:; Folio: 1/1; 230VAC; Brake; 24 VDC; Power Module 6SL3210; E_stop1; E_stop2; PROFINET; GND; Brake1; Brake2; ENC B-; ENC B+; ENC A-; ENC A+; LS1_DOWN; DVS-005R00; DELTA

SIEMENS Simatic HMI 6AV6647-0AD11-3AX0

Panel KTP600 Basic Color PN
