AetheRZX/MECH_458/Wiring/Wiring V2.pdf

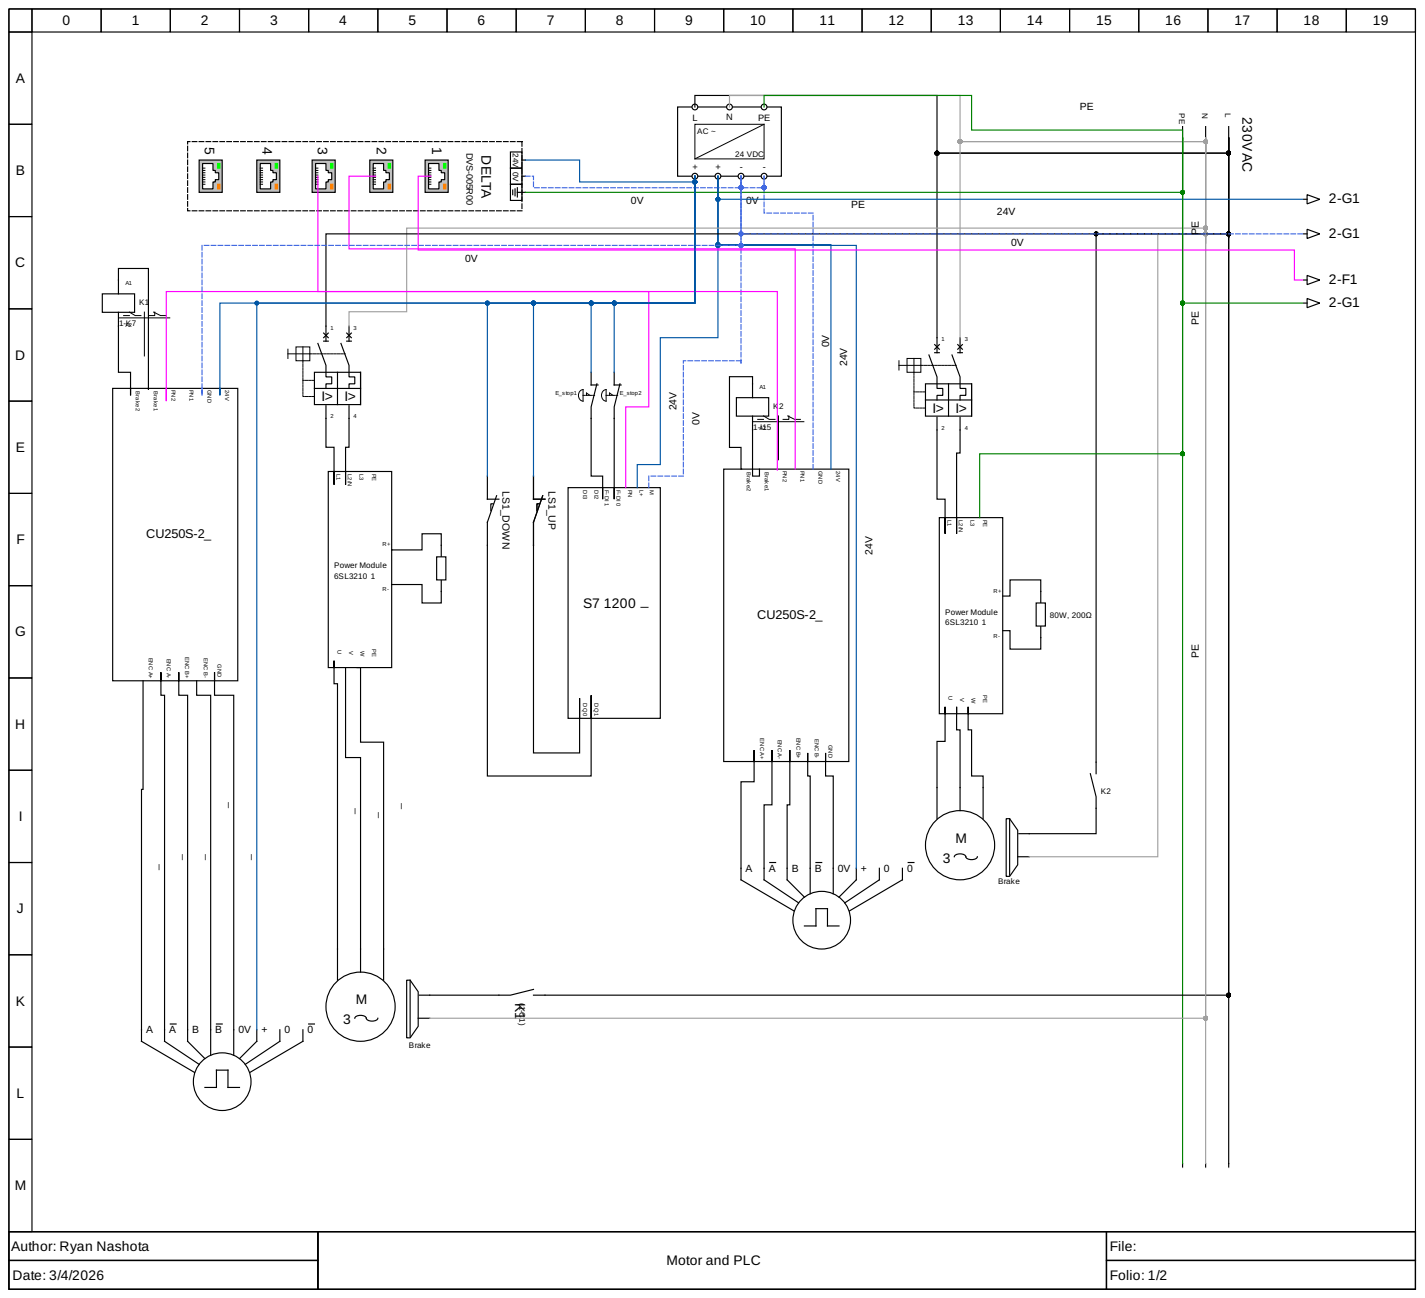
[picture p85: page 1]
Author: Ryan Nashota; Motor and PLC; File:; Date: 3/4/2026; Folio: 1/2; 230VAC; Brake; 24 VDC; Power Module 6SL3210; E_stop1; E_stop2; GND; Brake1; Brake2; ENC B-; ENC B+; ENC A-; ENC A+; LS1_DOWN; DVS-005R00; DELTA

0 | 1 | 2 | 3 | 4 | 5 | 6 | 7 | 8 | 9 | 10 | 11 | 12 | 13 | 14 | 15 | 16

A

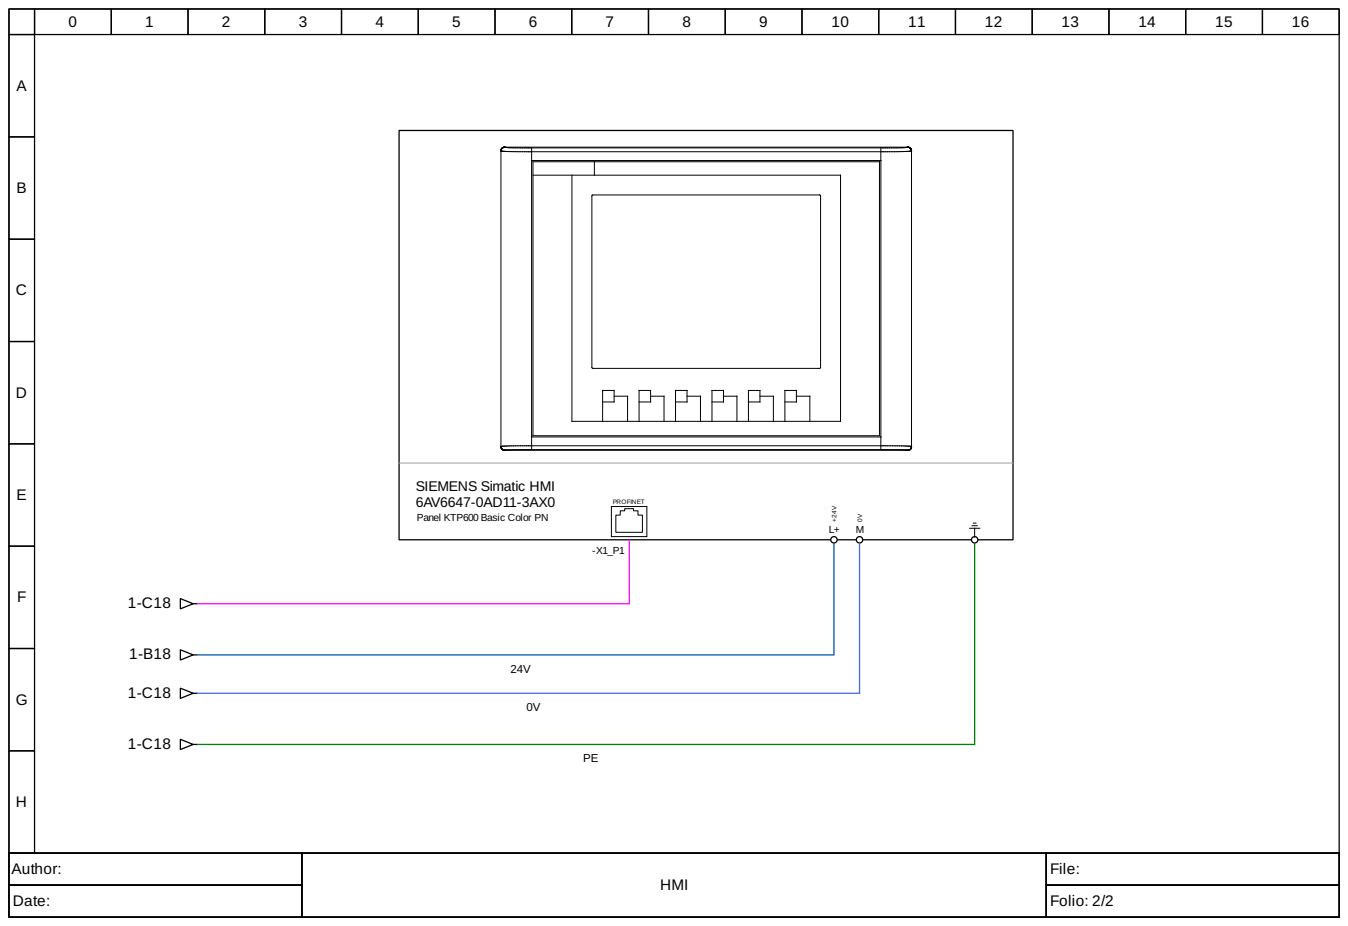
[picture p86: page 2]
Author:; HMI; File:; Date:; Folio: 2/2; PROFINET

SIEMENS Simatic HMI
Panel KTP600 Basic Color PN
