AetheRZX/MECH_458/Wiring/motor_wiring.pdf

0

1

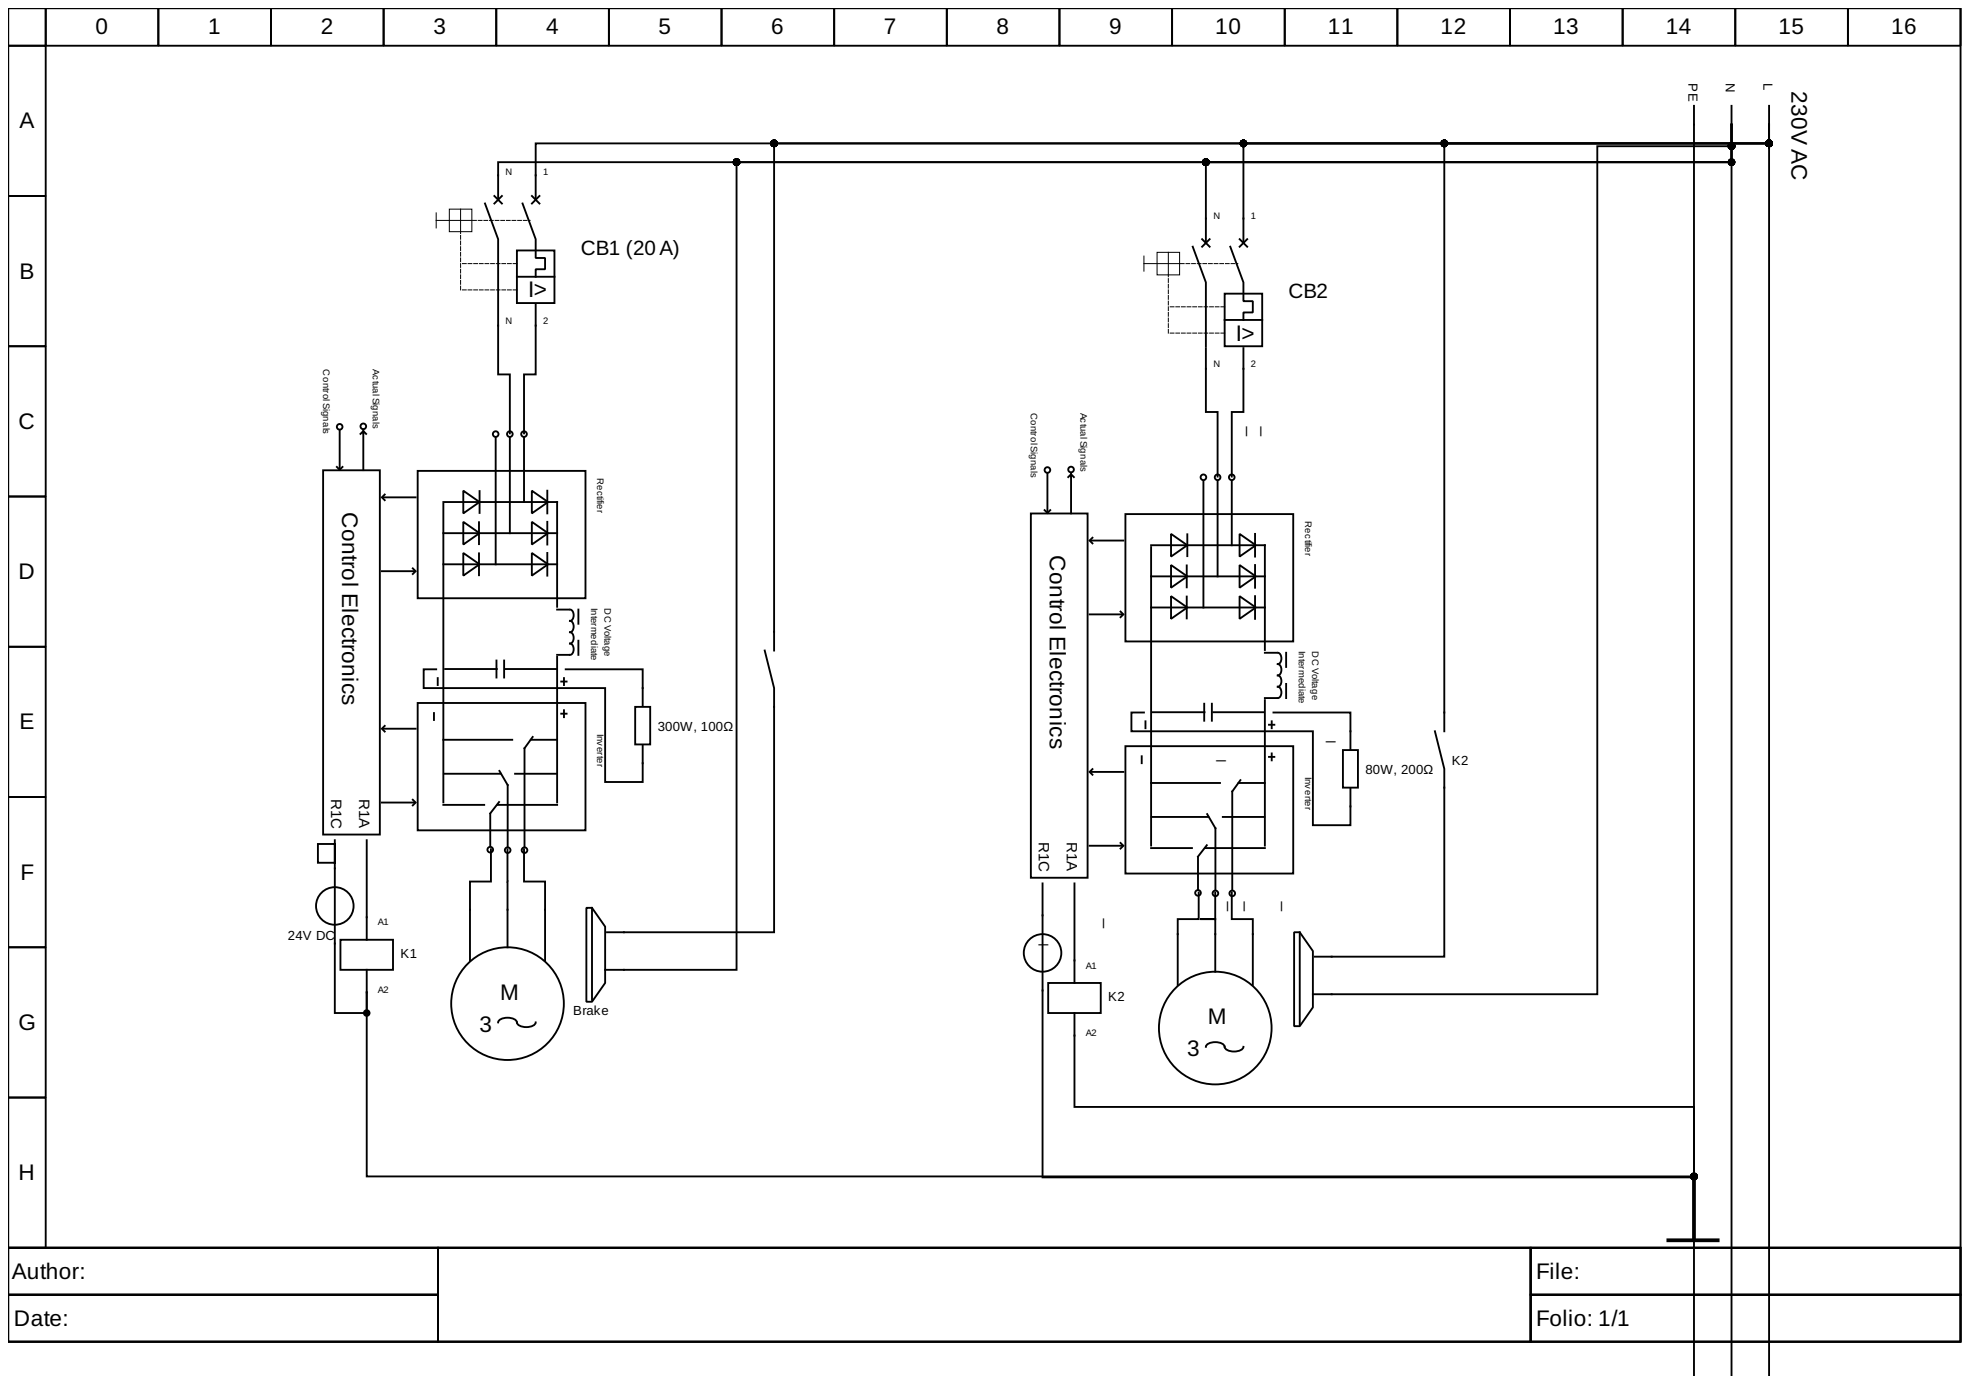
[picture p87: page 1]
ABCDEFGHAu; File: Date:; Folio: 1; 230VAC; Rectifier; DC Voltage; Intermediate Inverter; Control Signals; Actual Signals; Control Electronics
