AetheRZX/MECH_458/8B_system_diagram_V2/dLbTRkF84Nutu3iqPe5TZn3PacnP7c5ih2JB7WMIBOYQ6GJZmQ15DYN299lR9CUh3HP8W20d29BtFESXPqWEa3lCILBzHpP5YdPY6v3ONLMihlhgh_rZd62Mf86FxhyIXdt_YxMD4n9ykVRmcc7u90dsVE8S7XmU_836uGQ7Dd5Gd6nzBrmZbp8KCUgIEFPeY7s.pdf

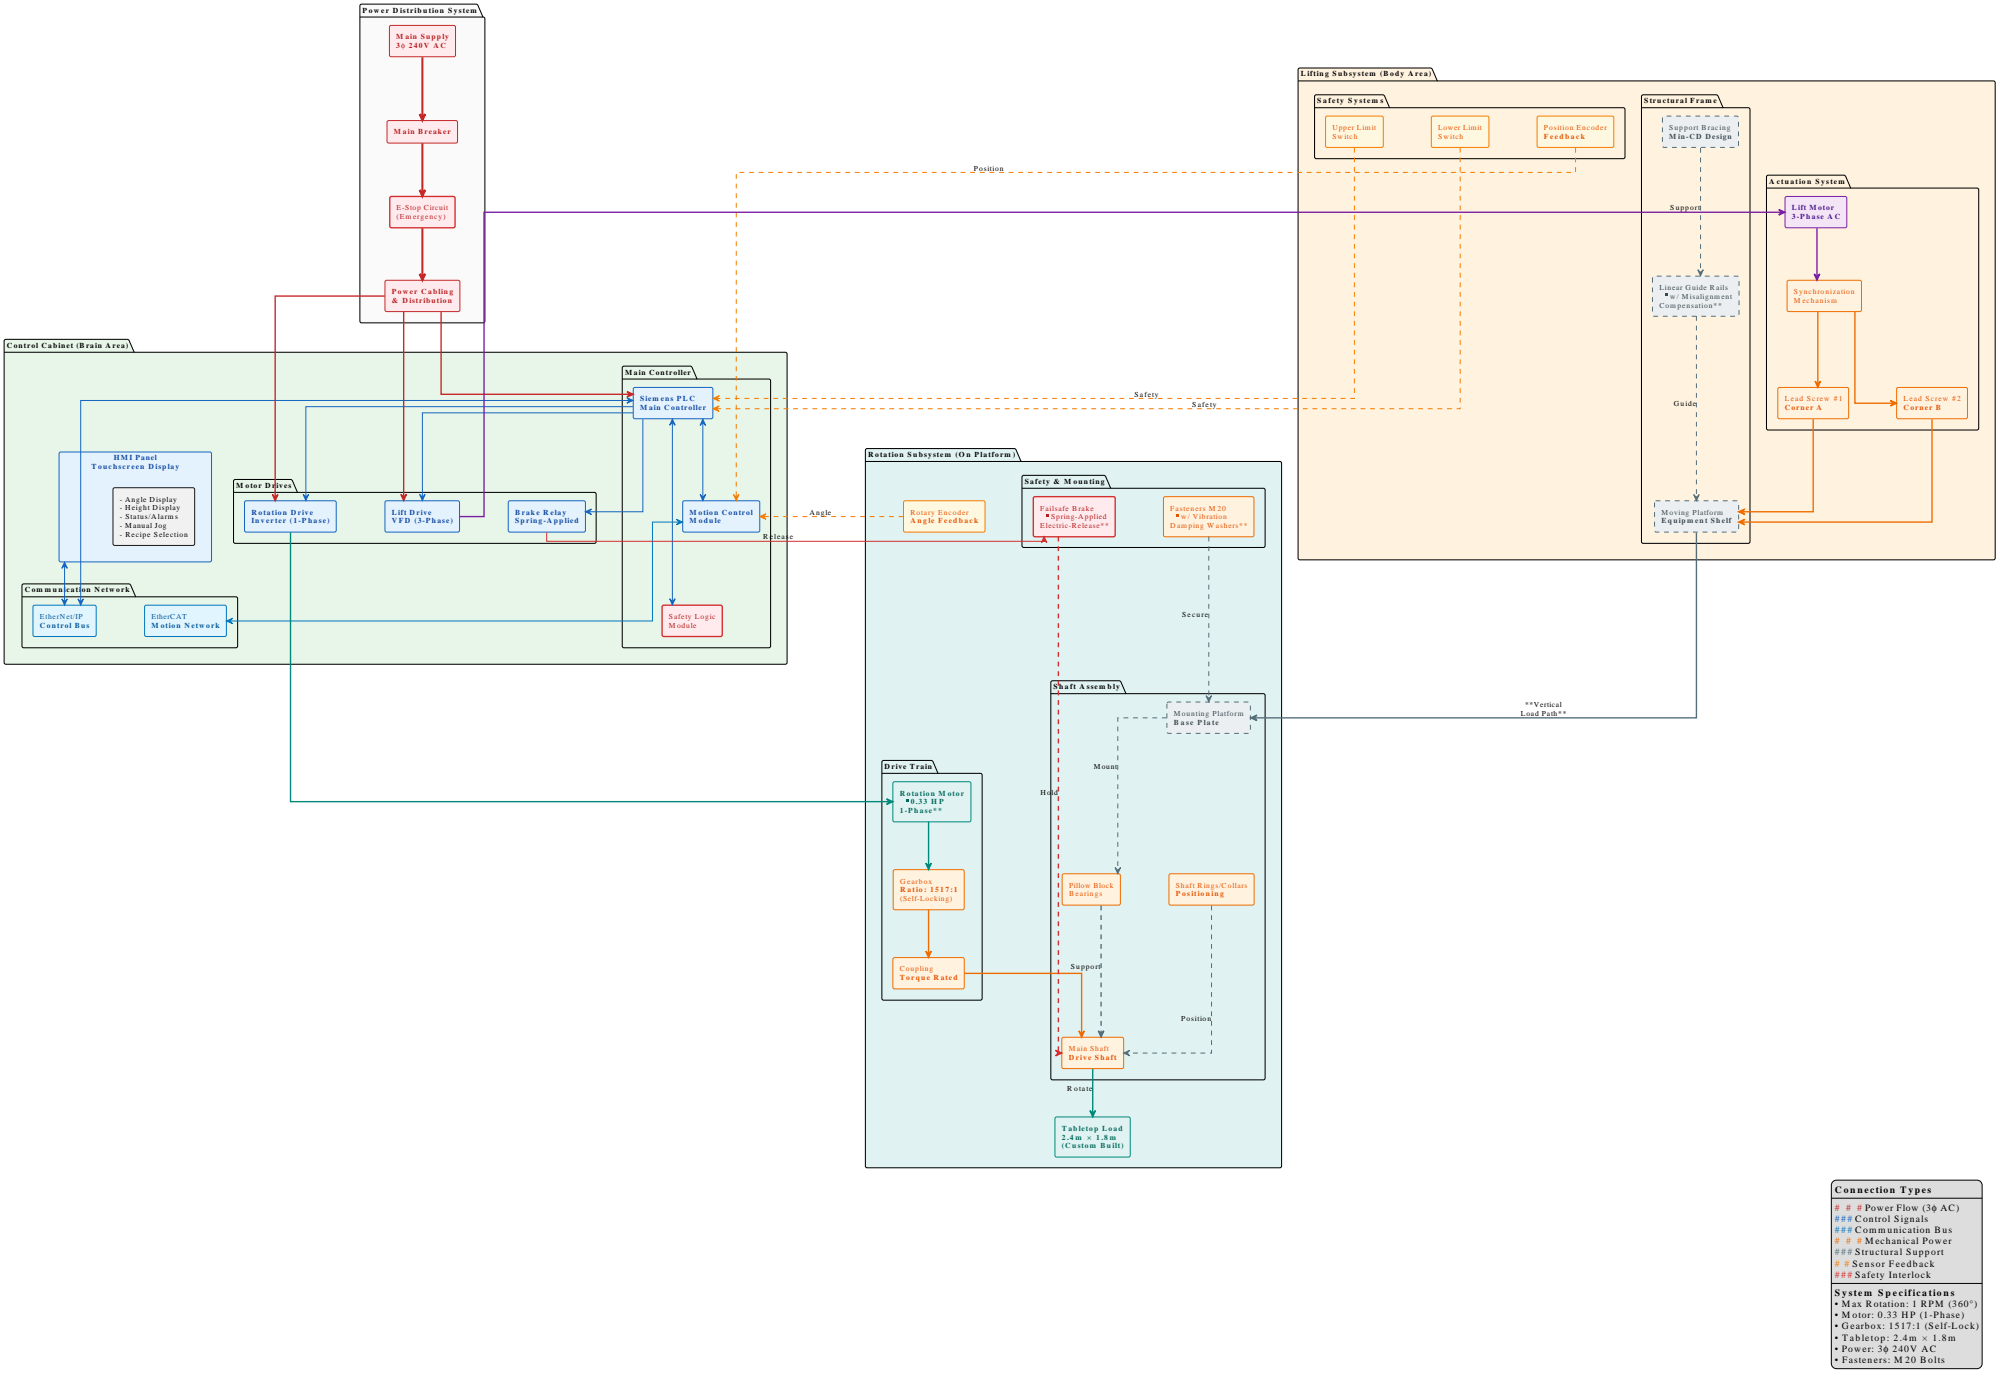
[picture p88: page 1]
H M I P anel T o u c h s c r e e n D is p la y; M o tio n C o n tro l M o d u le; Safety L ogic M odule; - A ngle D isplay - H eight D isplay - S tatu s/A larm s - M anual Jog - R ecipe S election; EtherCAT M o tio n N e tw o r k; L ift D riv e V F D (3 -P h a se ); B r a k e R e la y S p r in g -A p p lie d; L ift M otor 3 -P h a se A C; S u p p o rt B racin g M in -C D D esig n; M oving Platform E q u ip m e n t S h e lf; Lower Limit S w itch; P osition E ncoder F e e d b a c k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

P o w e r D is tr ib u tio n S y s te m

L iftin g S u b sy ste m (B o d y A r e a )

U pper Lim it
S w itch

M a in B rea k er

A c tu a tio n S y s te m

E-Stop Circuit
(E m erg en cy )

L inear G uide R ails
w / M isalignm ent
C om pensation**

P o w e r C a b lin g
& D istr ib u tio n

S ynchronization
M ech an ism

C o n tro l C a b in et (B ra in A rea )

M a in C o n tro ller

R o ta tio n S u b sy ste m (O n P la tfo r m )

S a fe ty & M o u n tin g

F asten ers M 2 0
w / V ibration
D am ping W ashers**

R o ta tio n D r iv e

C o m m u n ic a tio n N e tw o r k

E therN et/IP

D riv e T ra in

Shaft R ings/C ollars
P o s itio n in g

C o n n e c tio n T y p e s
# # # Power Flow (3φ AC)
# # # C ontrol S ignals
# # # C om m unication B us
# # # M echanical Pow er
# # # S tru ctu ral S u p p o rt
# # S en so r F eed b ack
# # # S afety Interlock
S y s te m S p e c ific a tio n s
• M ax R otation: 1 R PM (360°)
• M otor: 0.33 H P (1-P hase)
• G earbox: 1517:1 (S elf-L ock)
• Pow er: 3φ 240V A C
• F asten ers: M 2 0 B o lts
