AetheRZX/MECH_458/(commit log)

2025-11-28 fixed code a bit
    [a.csv, spin_test.csv, test1.csv, test2.csv]
2025-12-01 changed code
    [move.csv, moving.csv, test.csv]
2025-12-02 added kd
    [500.csv, test.csv, test1.csv, test2.csv]
2025-12-03 tuning pid
    [.csv, 100.csv, test.csv, test1.csv, testpid.csv]
2025-12-03 got a PID
    [.csv, test1.csv]
2025-12-03 tuned PID
    [test1.csv, test2.csv]
2025-12-03 master slave config
    [test.csv]
2026-01-17 added calc
    [2664N384_Metal Gear - 20 Degree Pressure Angle.SLDPRT, 4208N11_Splined Rotary Shaft.SLDPRT, 57545K227_Metal Worm.SLDPRT, 57545K613_Shaft-Mounted Worm.SLDPRT, 57545K793_Metal Worm Gear.SLDPRT, 6771K413_Flexible-Mount Right-Angle Speed Reducer.SLDPRT, 7014N33_Base-Mount AC Motors.SLDPRT, 9184T814_15 mm Wide x 1600 mm Long Rail Guide Rail for Maintenance-Free Ball Bearing Carriage.SLDPRT]
2026-03-04 backed up
    [2664N384_Metal Gear - 20 Degree Pressure Angle.SLDPRT, 4208N11_Splined Rotary Shaft.SLDPRT, 47065T122_T-Slotted Framing.SLDPRT, 47065T123_T-Slotted Framing(1).SLDPRT, 47065T239_Silver Corner Bracket.SLDPRT, 568610.STEP, 57545K227_Metal Worm.SLDPRT, 6771K413_Flexible-Mount Right-Angle Speed Reducer.SLDPRT]
2026-04-04 for gyan
    [6ES72281RC510AA0.stp, 6SL3246-0BA22-1FA0_3D_en.STP, Control_Panel_Wiring_Checklist.xlsx, JJY_023151720007.stp, TI-PG160 Build Assembly.STEP, TI-PG160.SLDPRT, Thomson Screw Jack.stp, VZ1000-11-1-12_JSY3000.stp]
