AetheRZX/MECH_458/(notices)

Notices in the files:
Enclsoure_CAD/JJY_023151720007.stp:
author */ ('License CC BY-ND 4.0'),
